elijohnsonn/Four-Topology-MOSbius/schematic review/Final Schematic Review (Shortened).pdf

# C1 Four Topology MOSbius

# Schematic Review Slides 07/03

LINK to Video (https://drive.google.com/file/d/1neRtkqYy5f7emF2jaVGr4DKSbaQKqrfV/view?usp=drive_link)

Discord name | Affiliation | Experience | Role
elij0100 | Columbia University | Undergraduate | Team Lead
boibun. | Columbia University | Undergraduate | Team Member
maxdrucker_83950 | Columbia University | Undergraduate | Team Member
Manwell | Columbia University | Undergraduate | Team Member

# Project Information

## Goal: To design and fabricate a chip containing several of the most common

amplifier topologies, all with accessible pins, so that a student can wire up, test,

## characterize, and compare each amplifier. Write a short lab manual to accompany

the chip (consider during design, but can follow design/layout submission).

## Students measure DC gain, GBW, slew rate, stability, PSRR, etc. for each amplifier, learning the trade-offs through hands-on experimentation

# System Overview

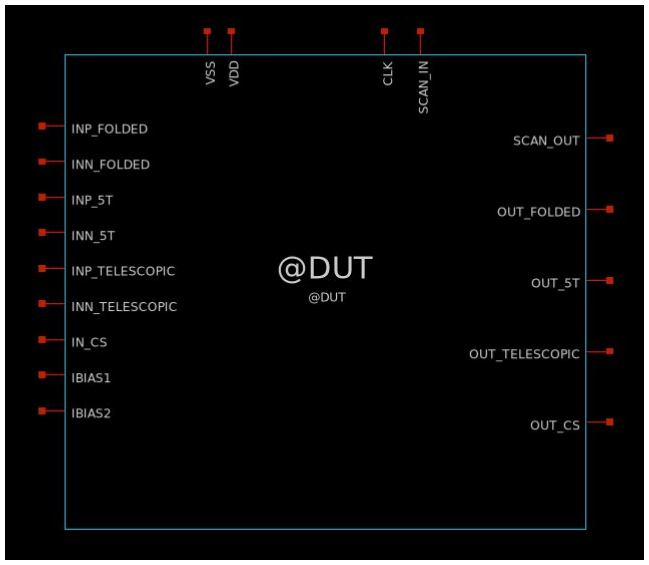
[picture p1: figure]

Total Pins: 17

Global Input (2): VDD, VSS

Digital Input (2): Scan In, Clock

Digital Output (1): Scan Out

Analog Input (8): IREF, IN(CS), INP/INN (5T), INP/INN (Telescopic), INP/INN (Folded)

Analog Output (4): OUT (CS), OUT (5T), OUT (Telescopic), OUT (Folded)

# System Block Diagram

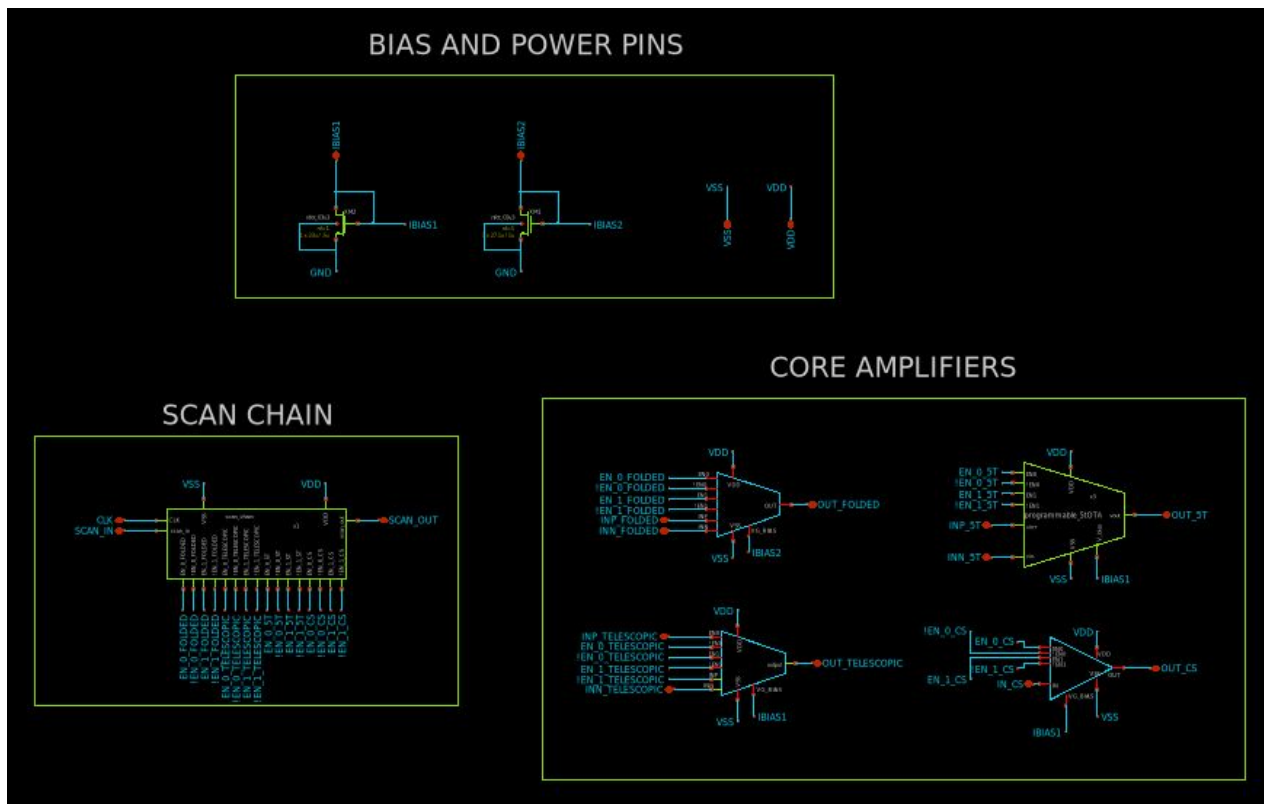
[picture p2: figure]

In practice, we will not have two separate bias currents. At the moment, there is some
mismatch between the initial current mirrors in the
amplifiers. This will be fixed so that we use only one externally generated bias current for the entire chip.

# System Testbench

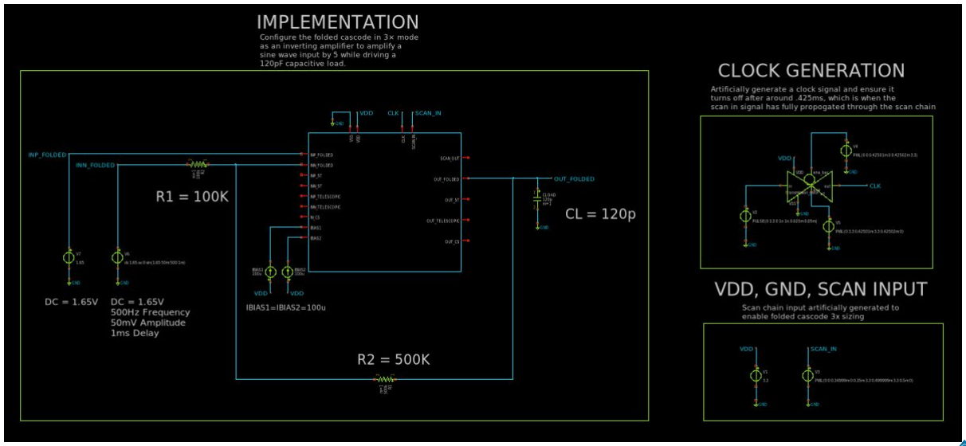
[picture p3: figure]

# System Simulation Results

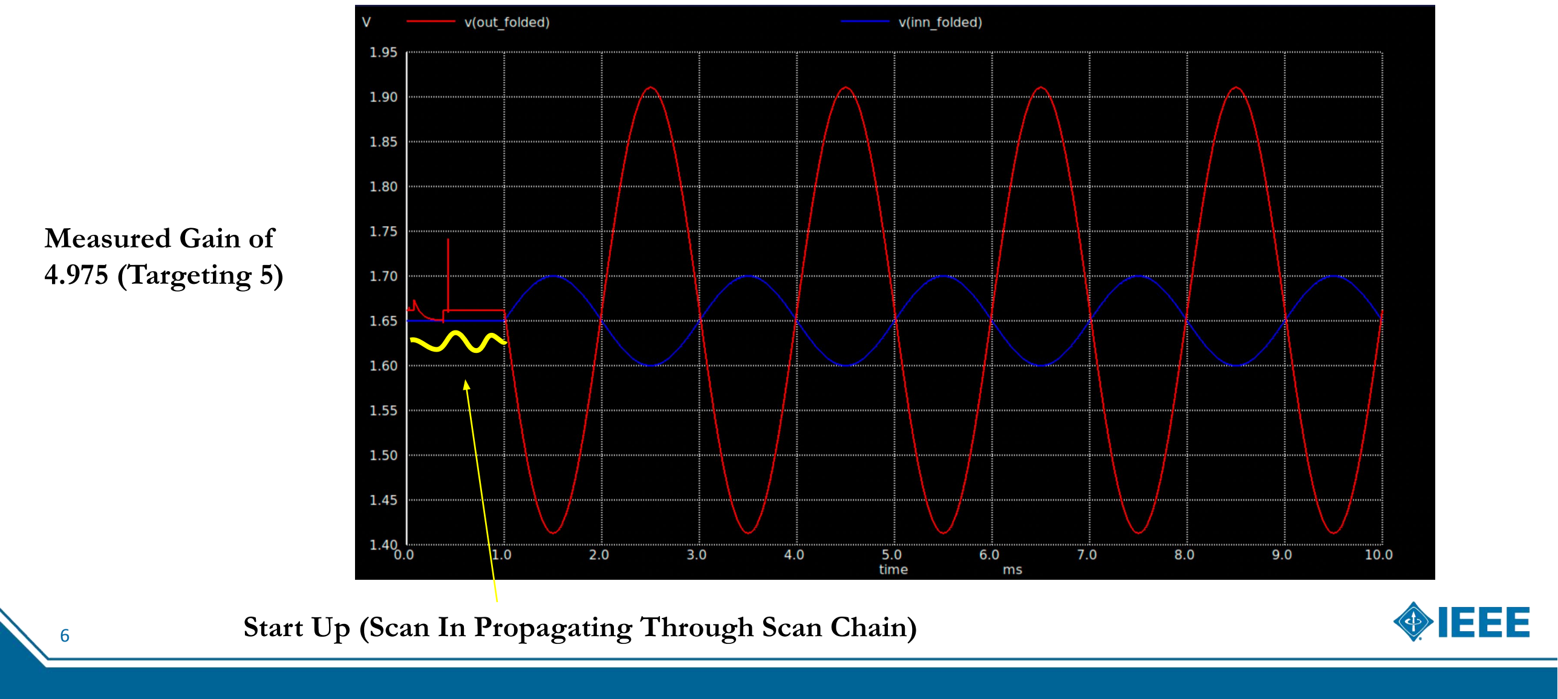
[picture p4: figure]
Measured Gain of 4.975 (Targeting 5)

Start Up (Scan In Propagating Through Scan Chain)

# Programmable Folded Cascode Schematic

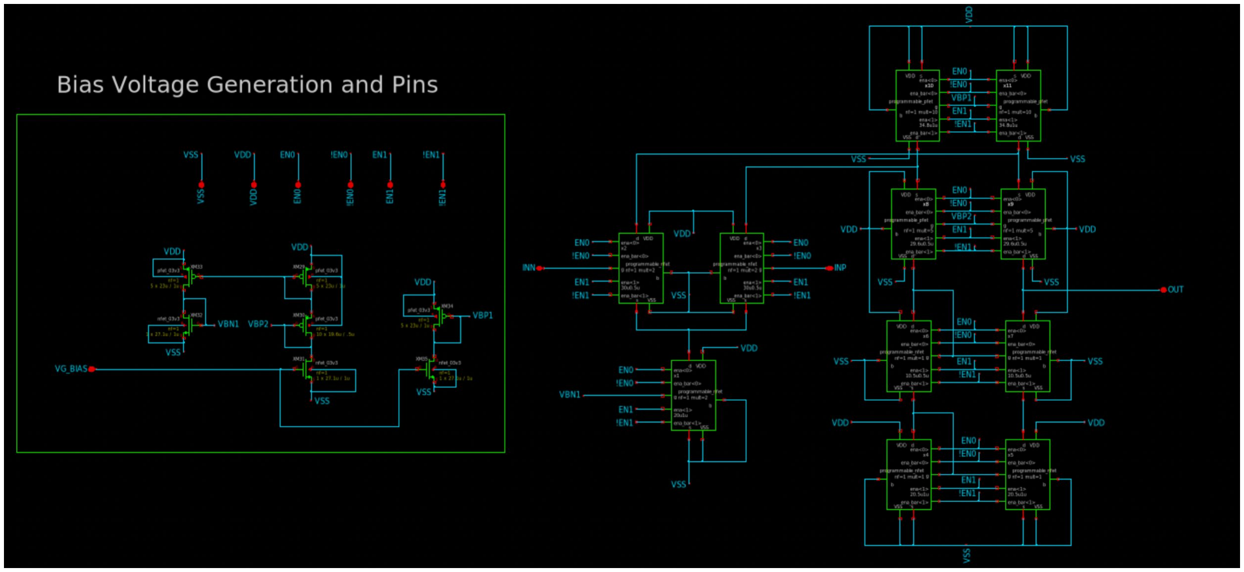
[picture p5: figure]

# Sizing and Device Information

Device | Role | W (µm) | L (µm) | ID (µA)
XM10/XM11 | NMOS input pair | 60 | 0.5 | 75
XM12 | NMOS tail | 40 | 1 | 150
XM2/XM5 | PMOS current sources | 174 | 1 | 150
XM3/XM4 | PMOS cascodes | 148 | 0.5 | 75
XM6/XM7 | NMOS cascodes | 10.5 | 0.5 | 75
XM8/XM9 | NMOS mirrors | 20.5 | 1 | 75
- VDD = 3.3 V
- IBIAS = 100 uA
- 3.3 V Devices
- Sizing for the
original amplifier
and base sizing for
programmable
amplifier is listed in
the table
- Total current
consumption is
approximately
300uA, giving
roughly 1mW at
3.3V

# AC Open-Loop

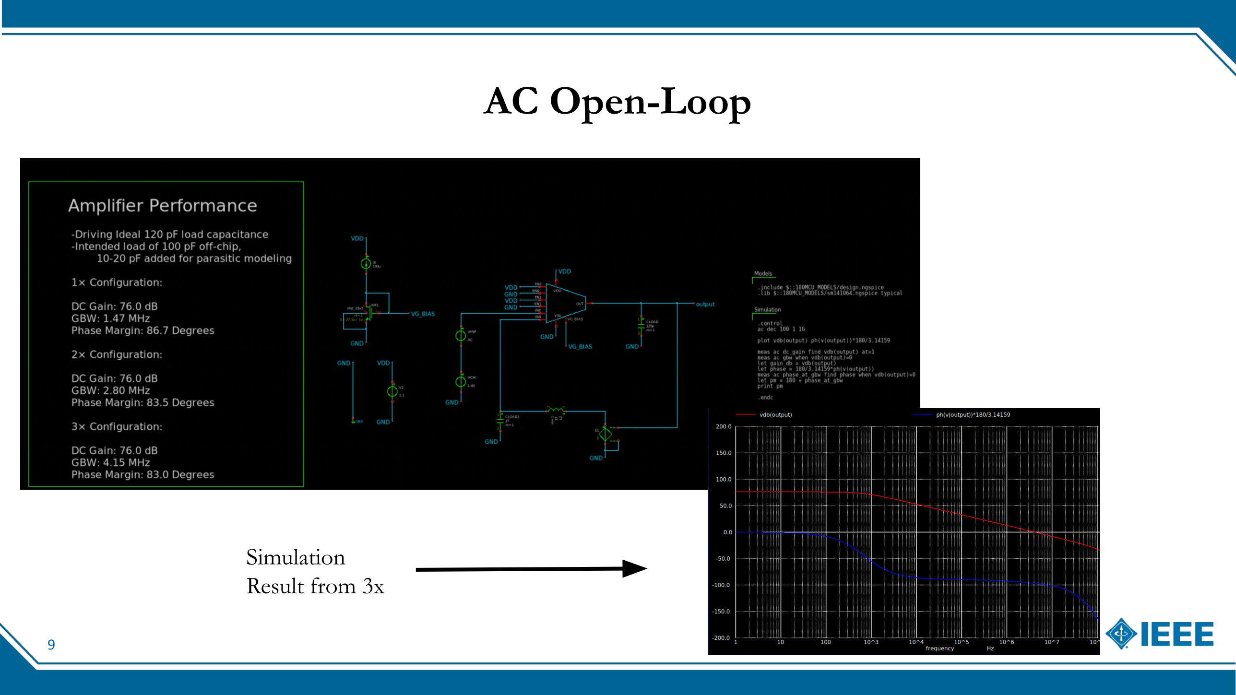
[picture p6: page 9]

Simulation
Result from 3x

# Programmable Telescopic Cascode

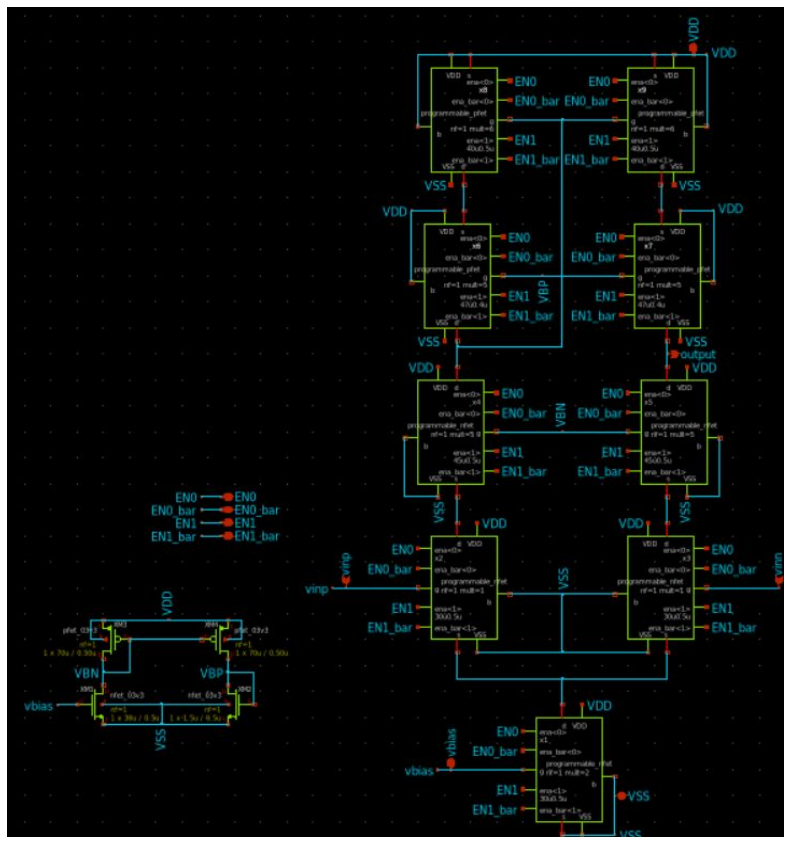
[picture p7: figure]

ID | Programmable | MOSFET | W (µm) (1x) | L (µm) (1x) | Multiplier

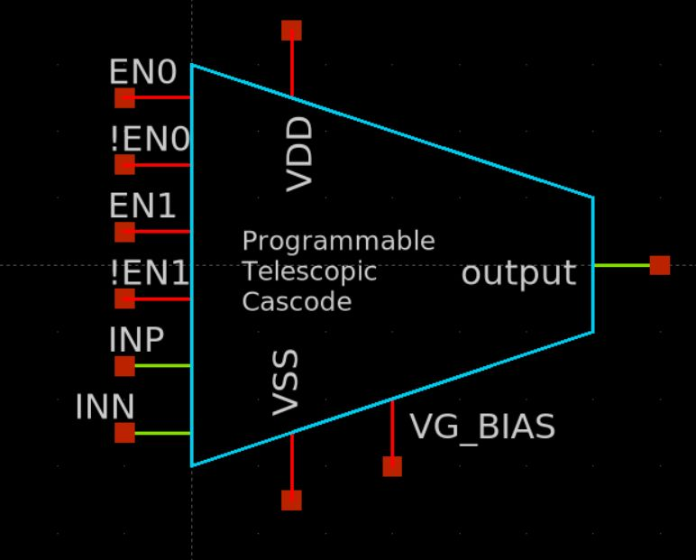
[picture p8: figure]

X1 | Programmable | 30 | .5 | 2
X2, X3 | Programmable | 30 | .5 | 1
X4, X5 | Programmable | 30 | .5 | 6
X6, X7 | Programmable | 47 | .4 | 5
X8, X9 | Programmable | 30 | .5 | 8
XM3, XM4 | PMOS | 70 | .5 | 1
XM2 | NMOS | 1.5 | .5 | 1
XM1 | NMOS | 30 | .5 | 1

Symbol View

# AC Open Loop

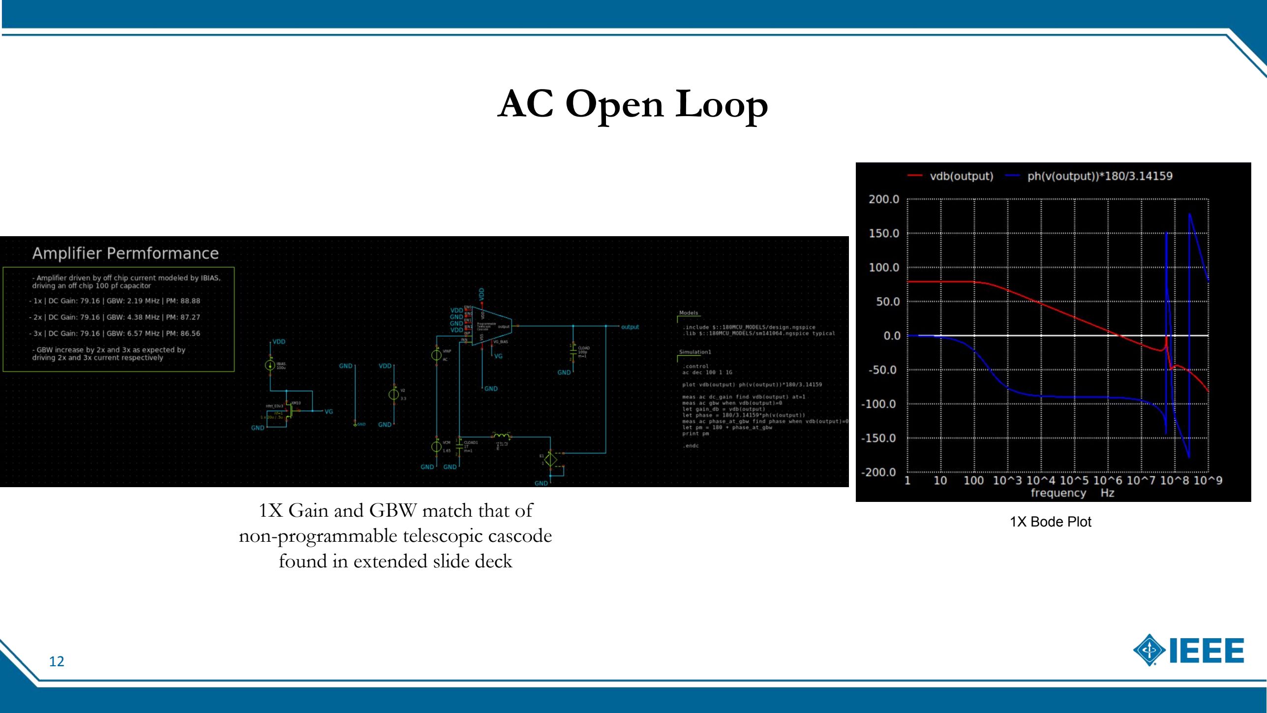
[picture p9: page 12]

1X Gain and GBW match that of non-programmable telescopic cascode found in extended slide deck

1X Bode Plot

# Scan Chain

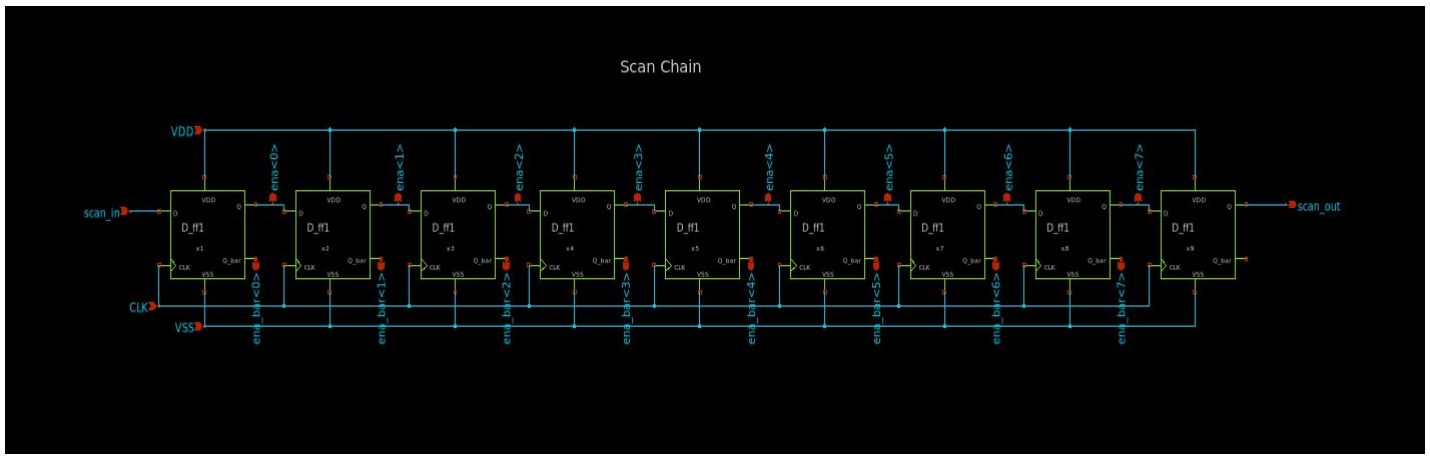
[picture p10: figure]

# Scan Chain Simulation

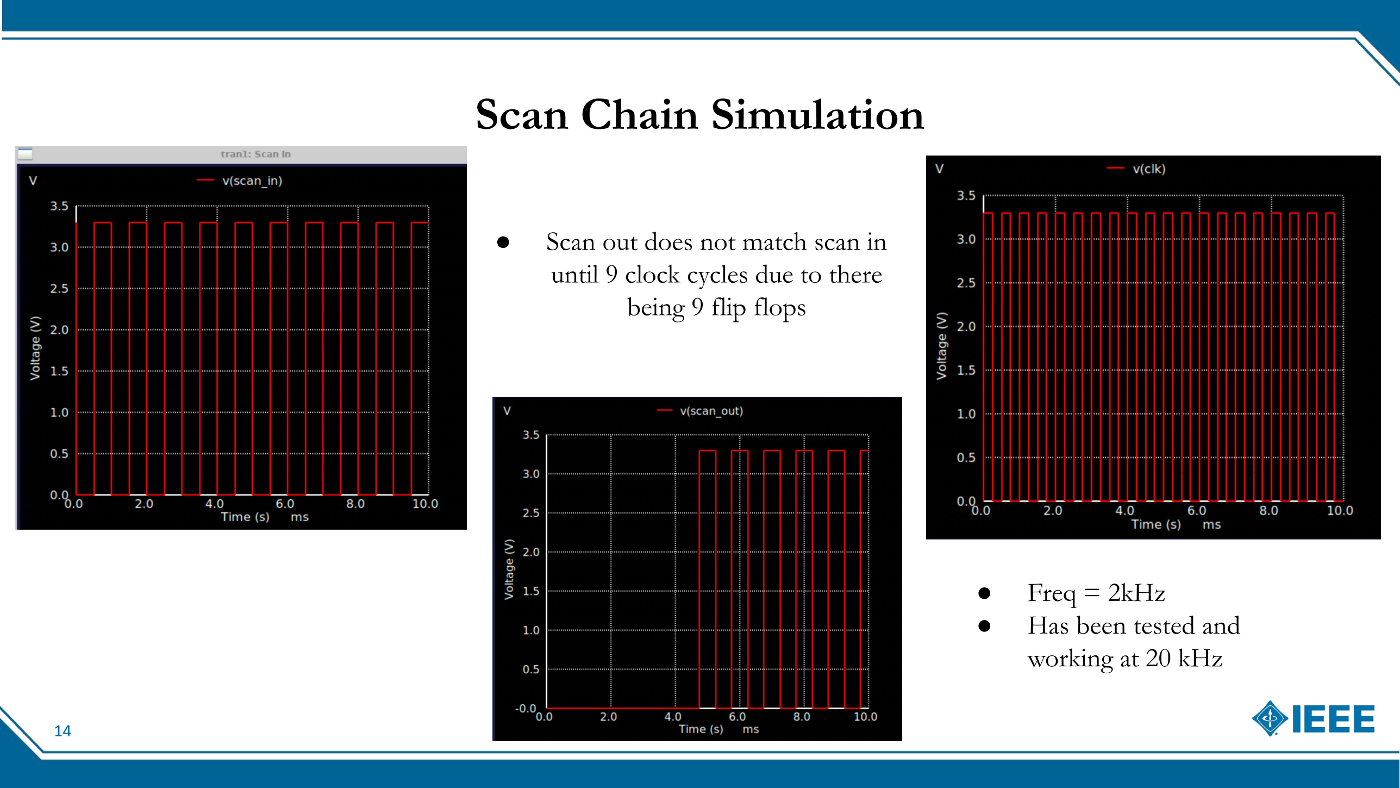
[picture p11: page 14]

- Freq = 2kHz
- Has been tested and
working at 20 kHz
- Scan out does not match scan in until 9 clock cycles due to there being 9 flip flops

# Programmable Transistors

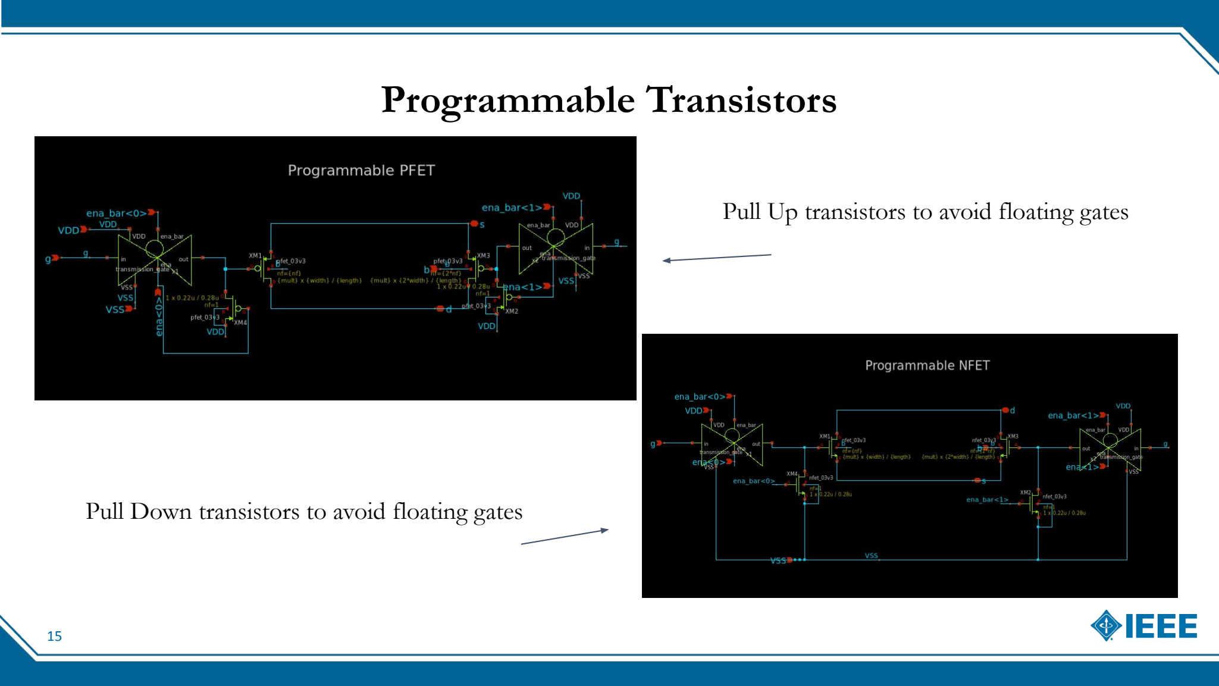
[picture p12: page 15]

Pull Down transistors to avoid floating gates

Pull Up transistors to avoid floating gates

# Programmable 5-Transistor OTA

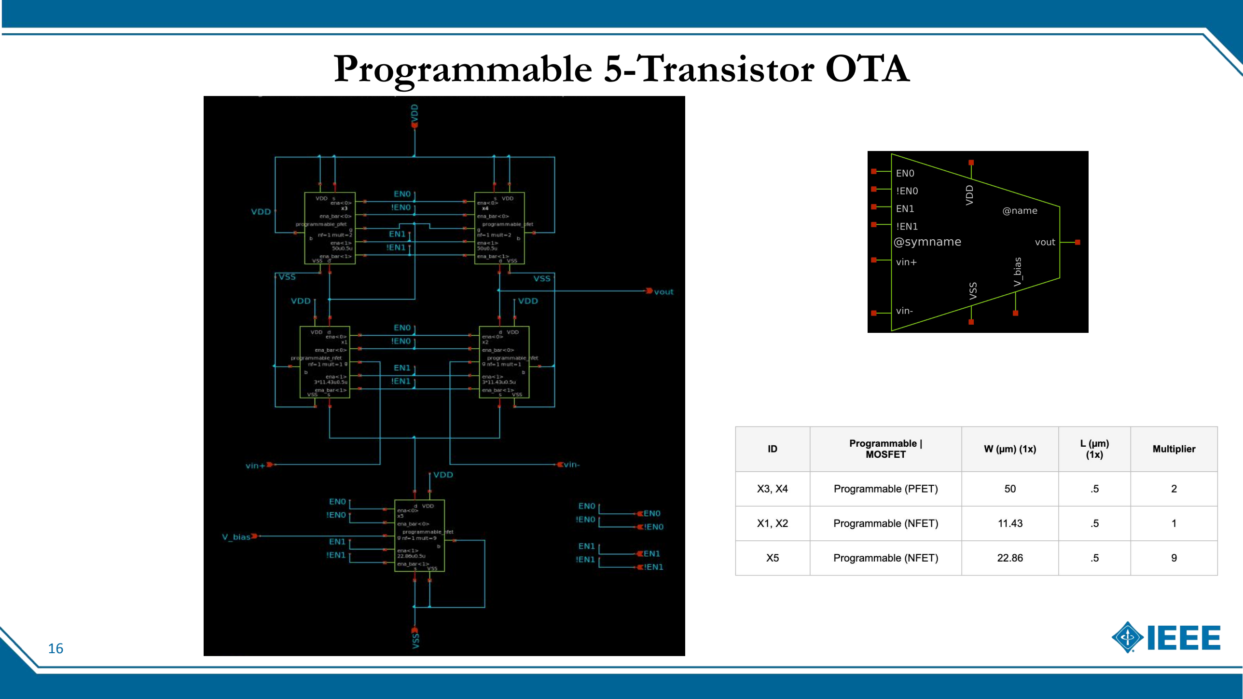
[picture p13: page 16]

# Programmable 5-Transistor OTA - DC Unity

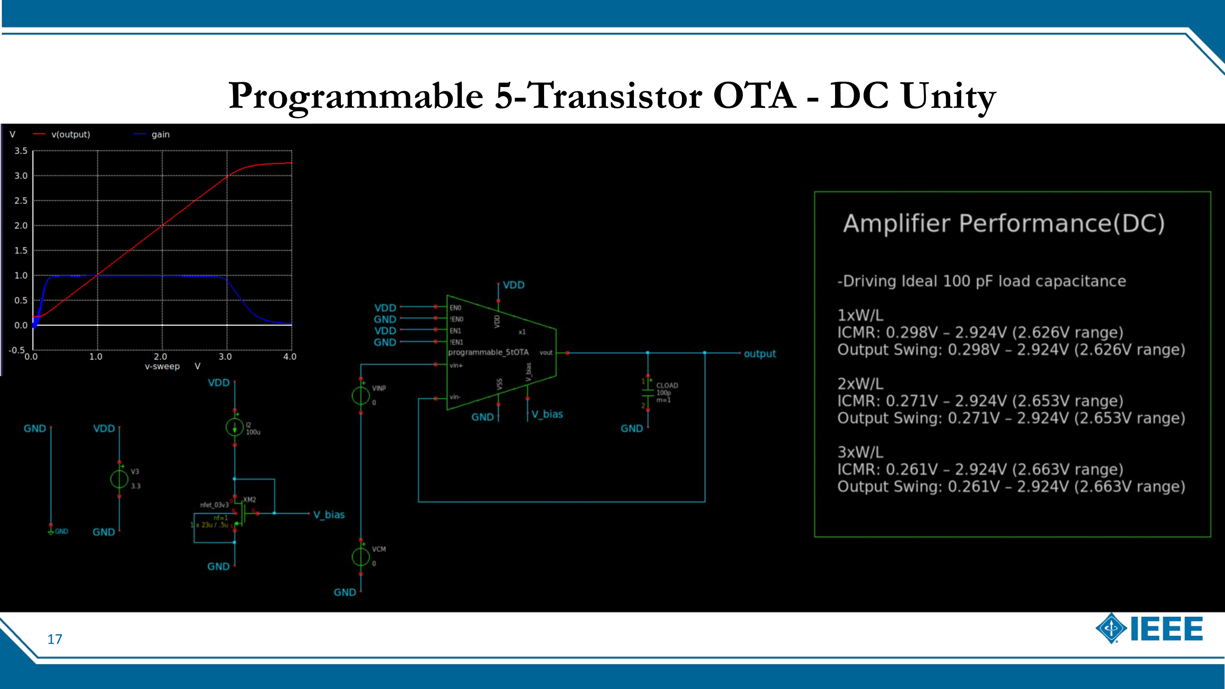
[picture p14: page 17]

# Programmable 5-Transistor OTA - Slew Rate

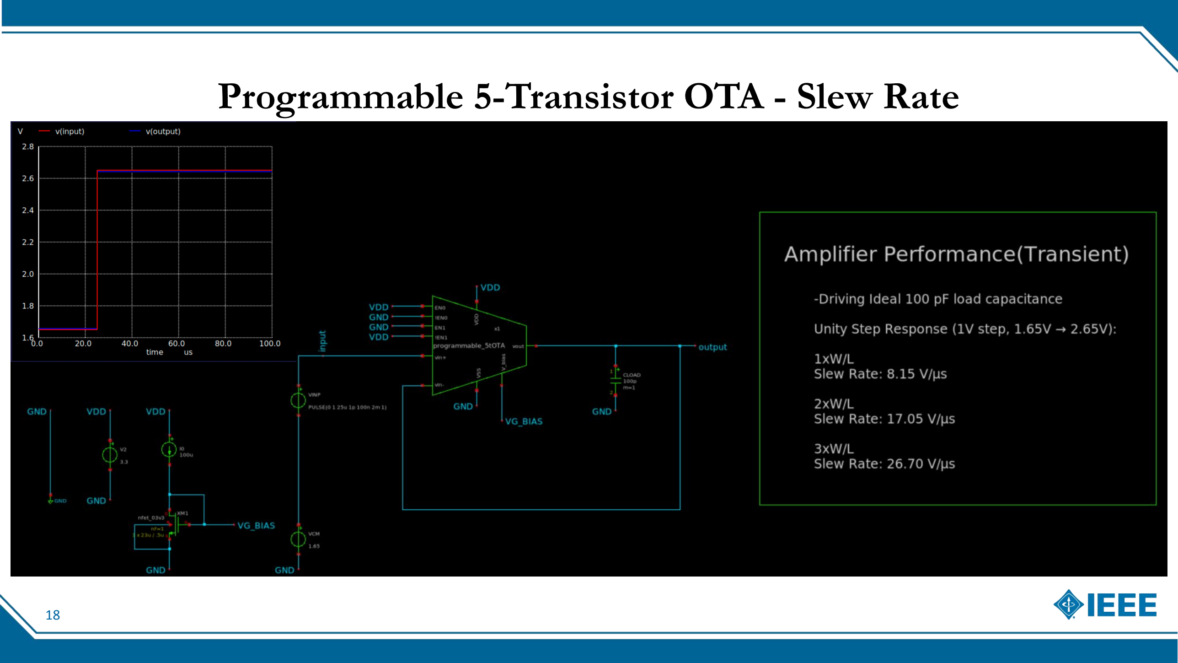
[picture p15: page 18]

# Programmable 5-Transistor OTA AC

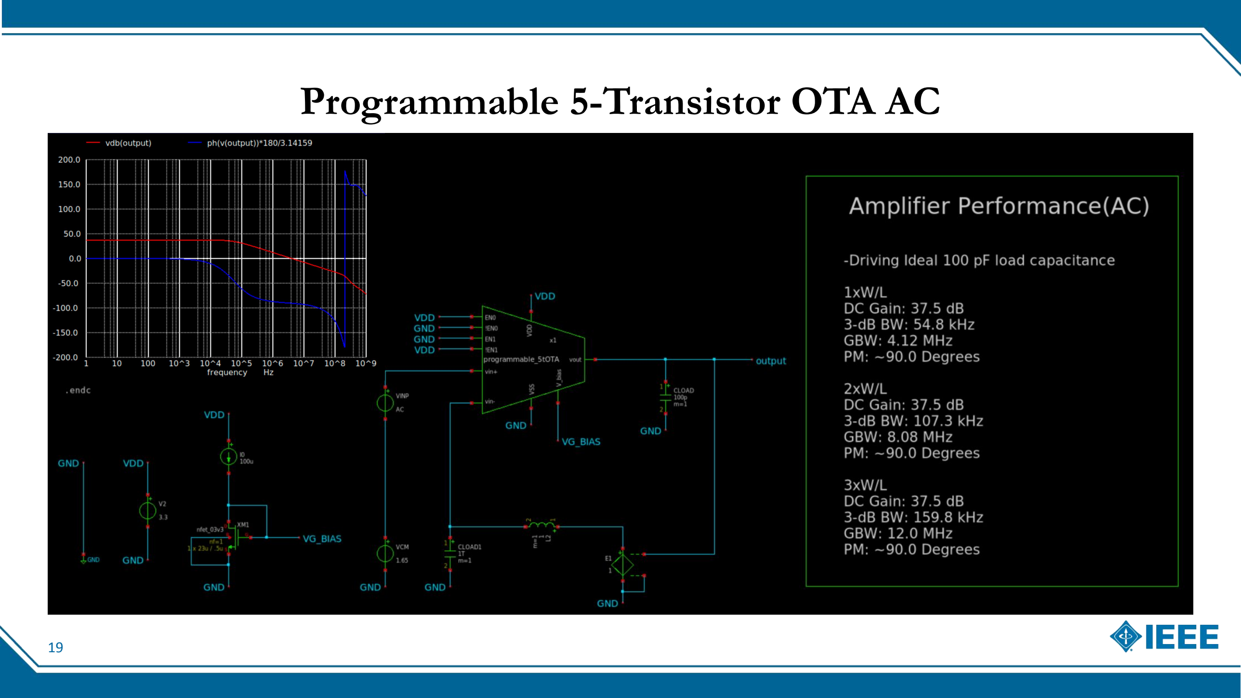
[picture p16: page 19]

# Next Steps

- Continue to Test System-Level Configurations and Specifications
- Experiment and Document Two-Stage Configurations, Compensation
- More Characterization Simulations (Noise and PSRR)
- Begin Layout

# Thank You!

# Any feedback is greatly appreciated. Please view our full slide deck linked on our repository and issue for more

simulations and calculations.
