elijohnsonn/Four-Topology-MOSbius/brief pex/Brief PEX Results.pdf

# C1 Four Topology MOSbius

## Brief PEX Results and Introduction

Discord name | Affiliation | Experience | Role
elij0100 | Columbia University | Undergraduate | Team Lead
boibun. | Columbia University | Undergraduate | Team Member
maxdrucker_83950 | Columbia University | Undergraduate | Team Member
Manwell | Columbia University | Undergraduate | Team Member

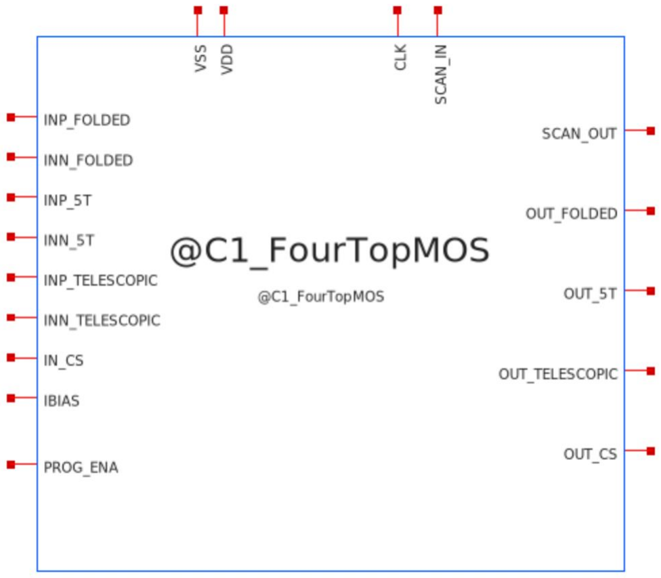
[picture p36: figure]
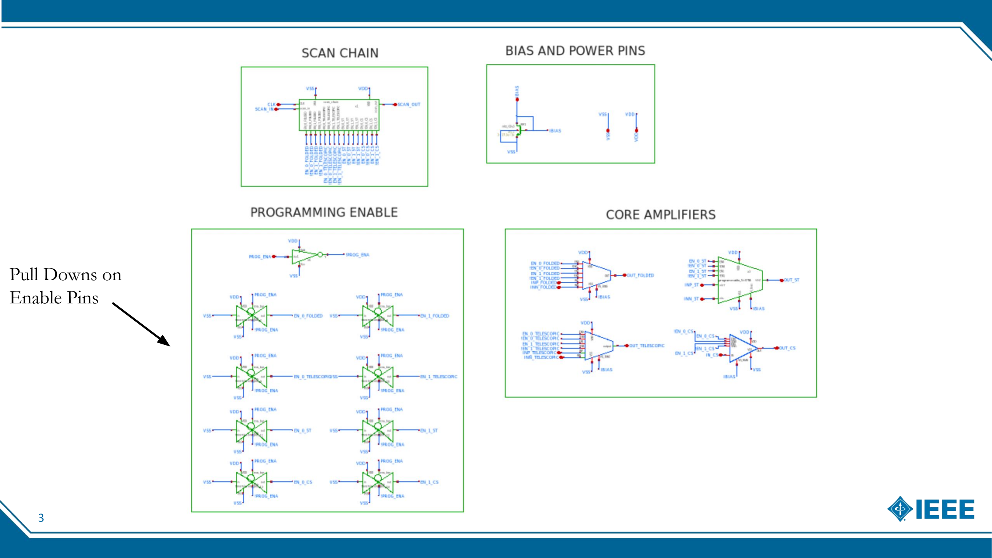
[picture p37: page 3]

Pull Downs on
Enable Pins

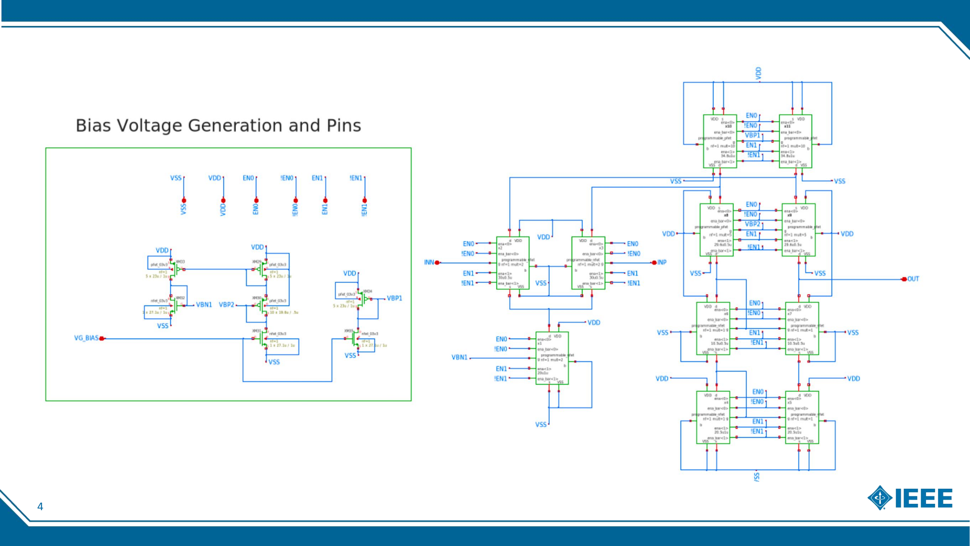
[picture p38: page 4]

# Folded Cascode Sizing

Device | Role | W (µm) | L (µm) | ID (µA)
XM10/XM11 | NMOS input pair | 60 | 0.5 | 75
XM12 | NMOS tail | 40 | 1 | 150
XM2/XM5 | PMOS current sources | 174 | 1 | 150
XM3/XM4 | PMOS cascodes | 148 | 0.5 | 75
XM6/XM7 | NMOS cascodes | 10.5 | 0.5 | 75
XM8/XM9 | NMOS mirrors | 20.5 | 1 | 75

(Default sizing shown,

## for 2x, 3x, and 4x sizing, the width and bias current would scale respectively for all amplifiers)

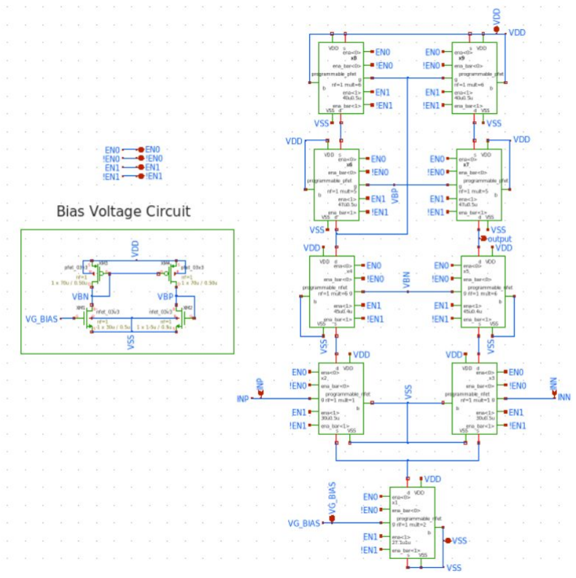
[picture p39: figure]

Device | Role | W (µm) | L (µm) | ID (µA)
XM1 | NMOS Tail | 60 | 0.5 | 200
XM2/XM3 | Input Pair | 30 | 0.5 | 100
XM4/XM5 | NMOS Cascode | 180 | 0.5 | 100
XM6/XM7 | PMOS Cascodes | 235 | 0.4 | 100
XM8/XM9 | PMOS Current Sources | 240 | 0.5 | 100

# Telescopic Cascode Sizing

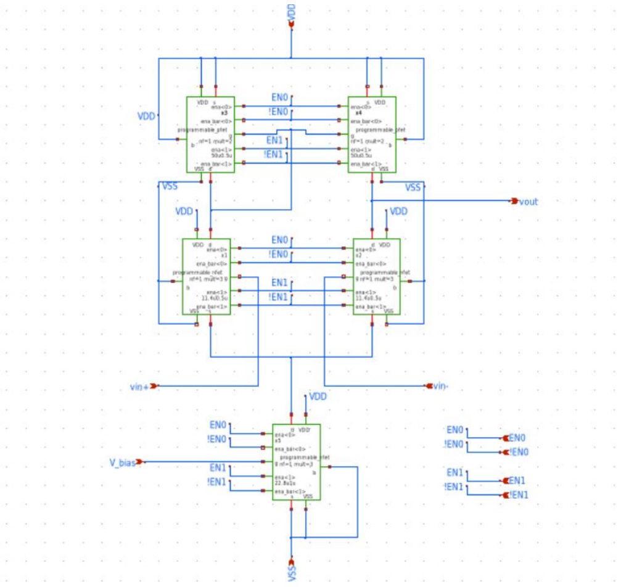
[picture p40: figure]

# 5-Transistor Sizing

Device | Role | W (µm) | L (µm) | ID (µA)
XM1/XM2 | Input Pair | 34.2 | 0.5 | 150
XM3/XM4 | PMOS Active Load | 100 | 0.5 | 150
XM5 | NMOS Tail | 68.4 | 0.5 | 300

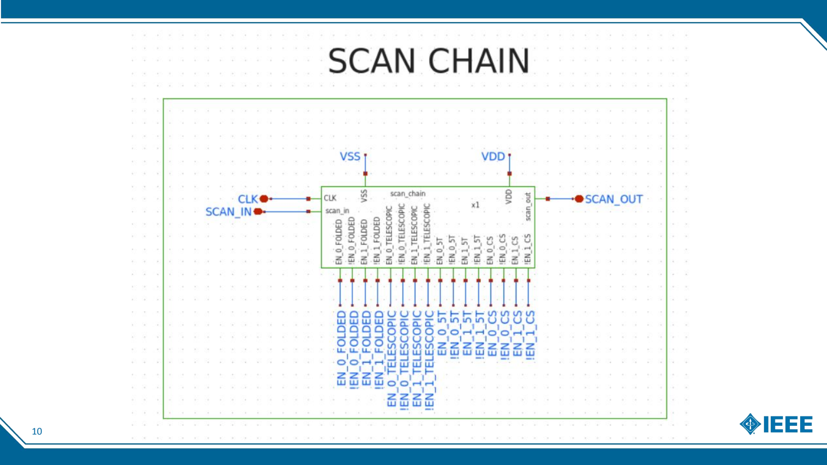
[picture p41: page 10]

Programmable PFET | Programmable NFET

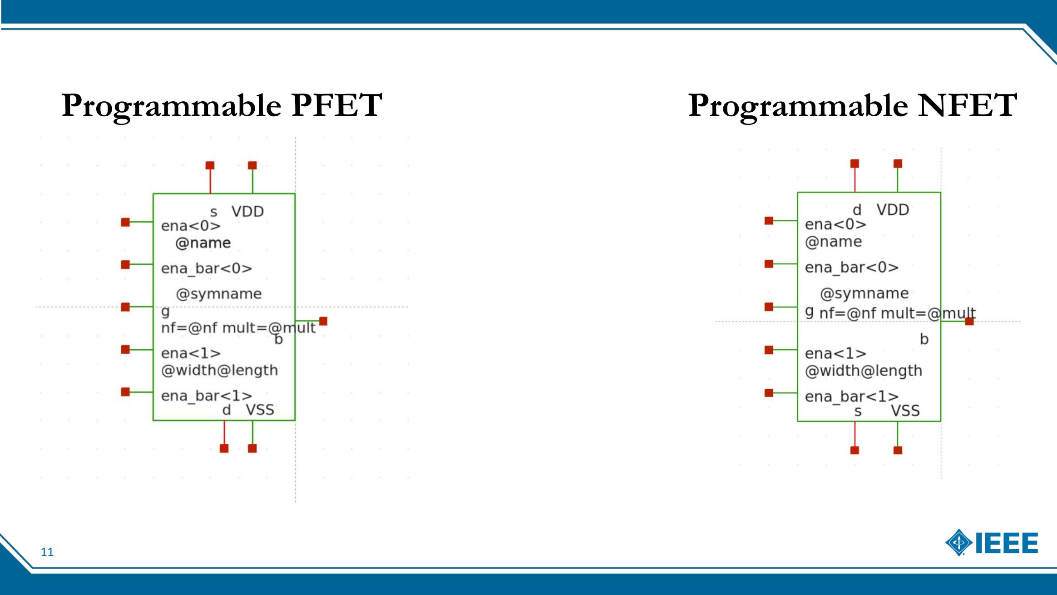
[picture p42: page 11]

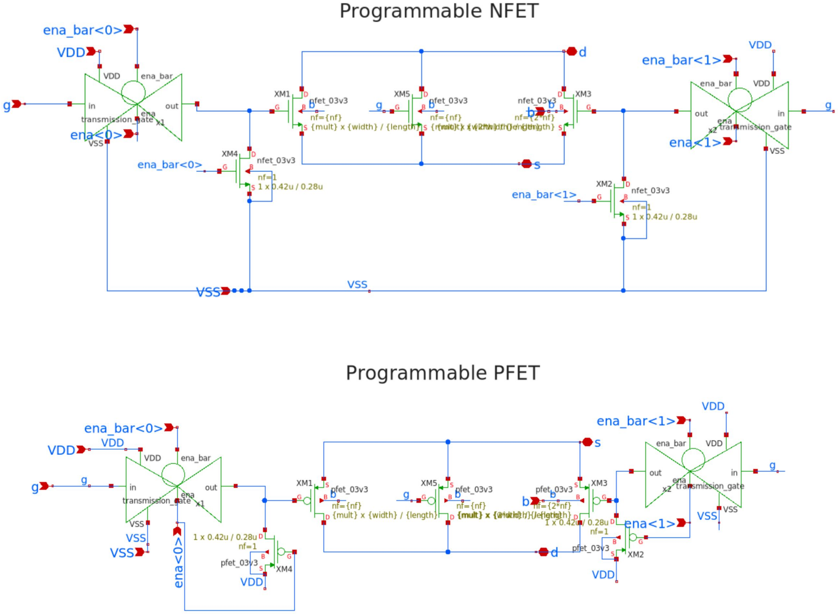
[picture p43: figure]
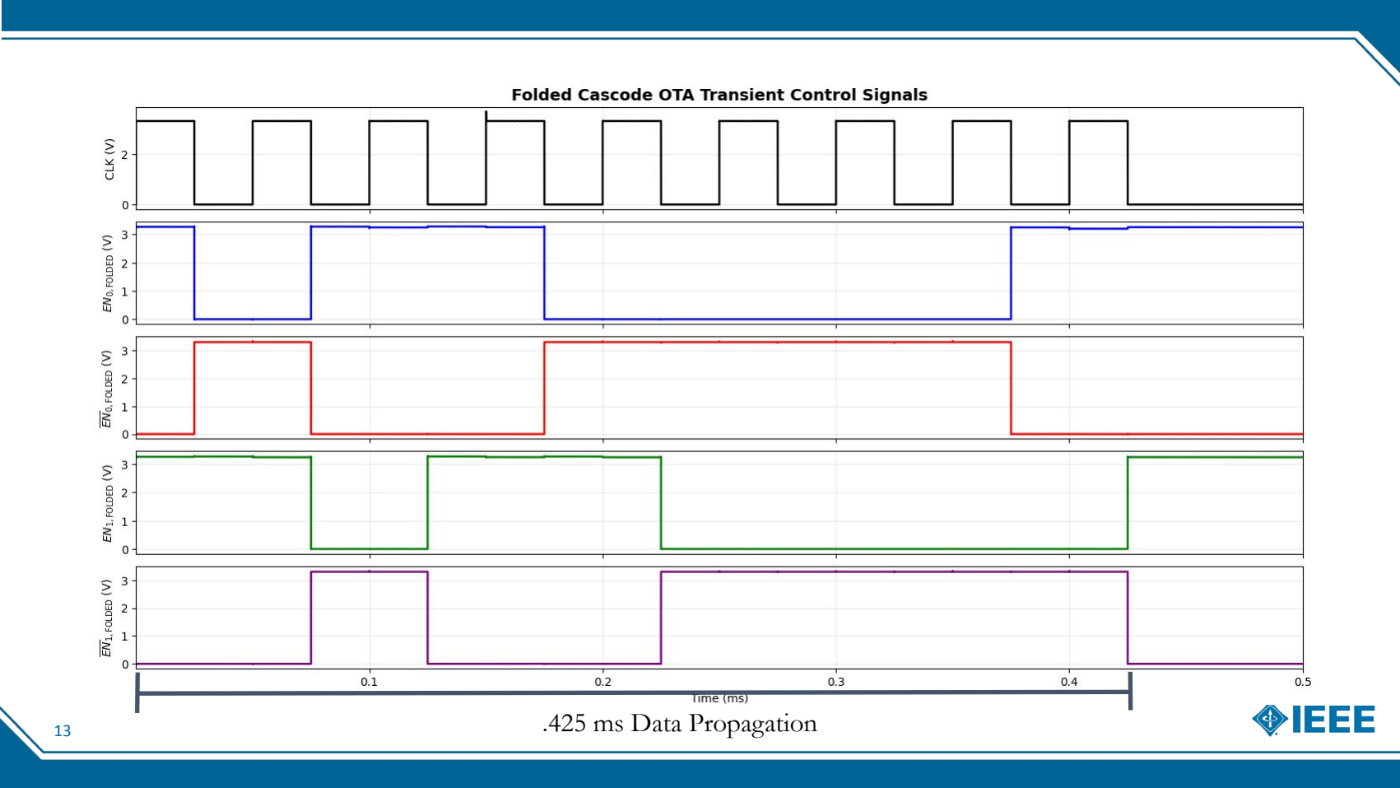
[picture p44: page 13]

13 | .425 ms Data Propagation

# Start-Up CleaningCircuitry (SIMULATION ONLY)

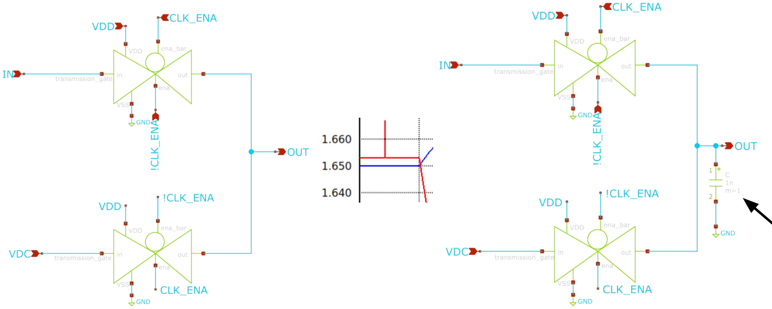
[picture p45: figure]

Start-up transients are present at the output when enable signals propagate through the scan chain. To mitigate this, a switch ties the output to VCM while the enable signal propagates. Once the enable logic stabilizes, the switch restores the actual output to the output pin

1nF cap to create a
more overdamped
response, only use at
lower frequencies

The following configuration uses the Four-Topology MOSbius set up as an inverting amplifier. The gain of 5 is established using external feedback resistors, 500kΩ and 100kΩ. A switch is included to tie the outputs to VCM during start-up, preventing instability or undefined states as the circuit powers on. There is no additional capacitance present in this implementation of the switch. This setup also uses a PEX (parasitic-extracted) netlist.

# Example Testbench

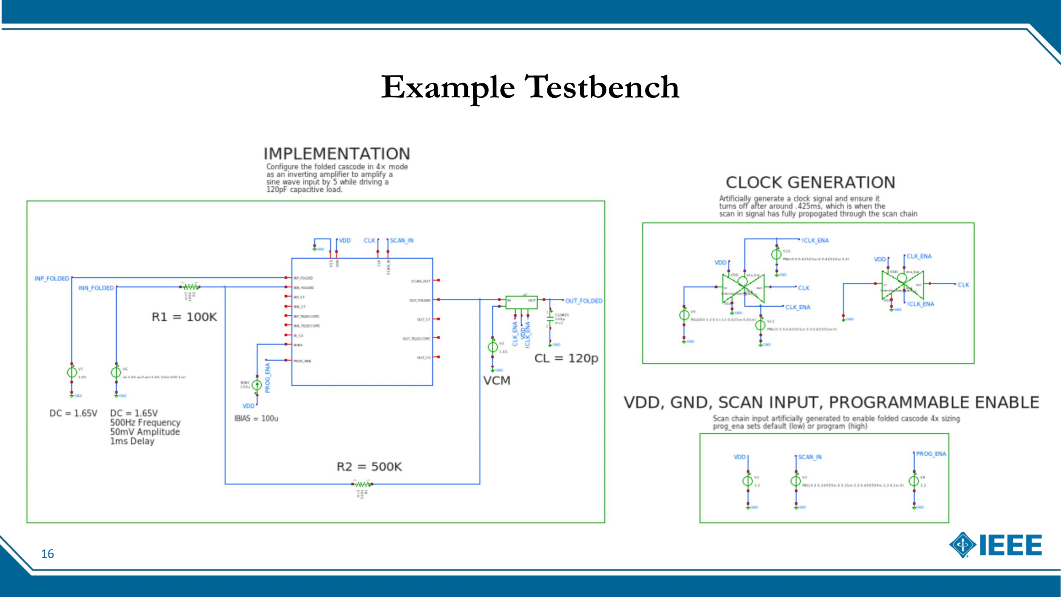
[picture p46: page 16]
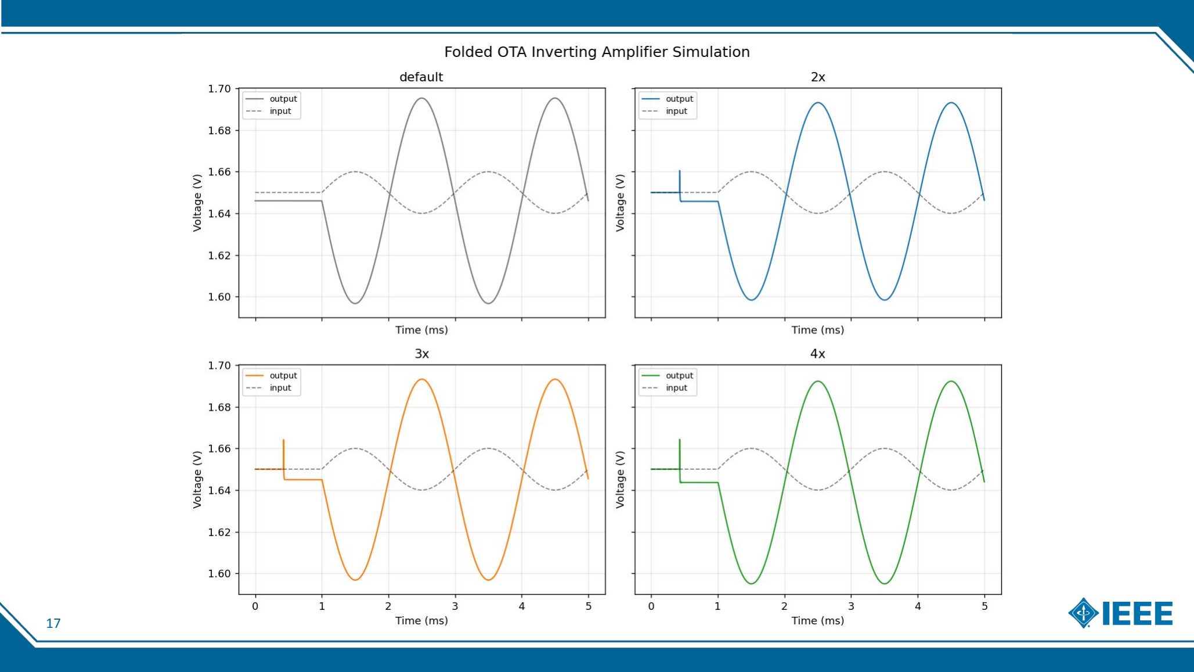
[picture p47: page 17]
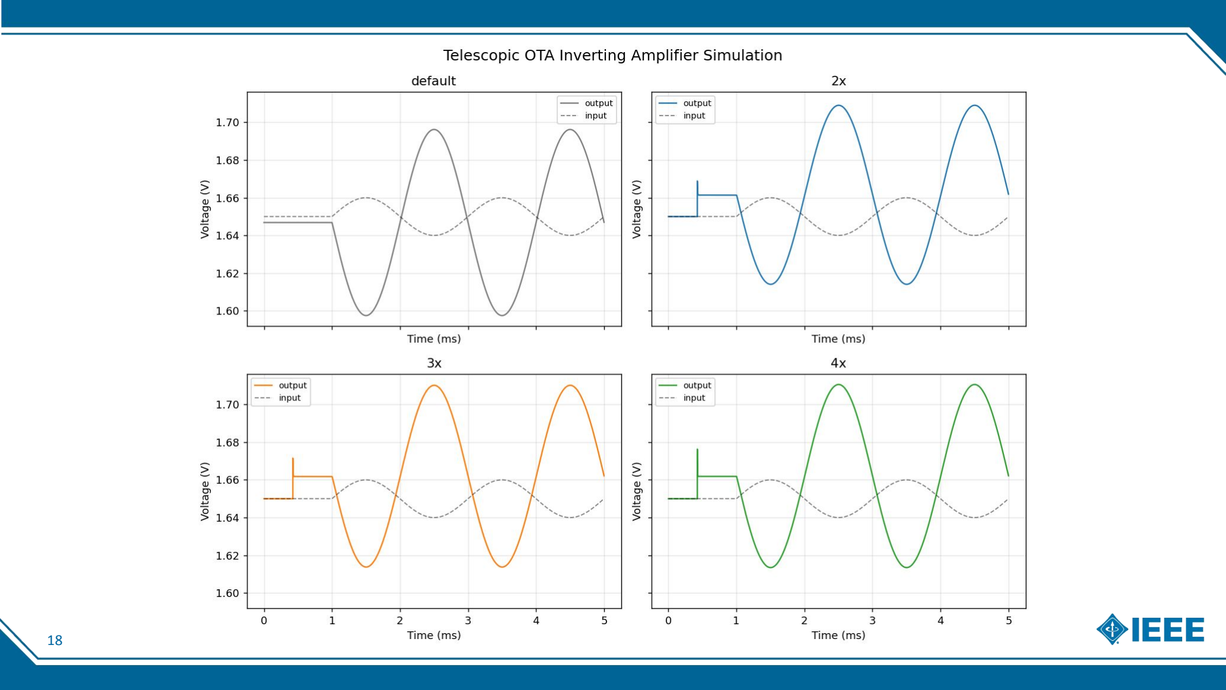
[picture p48: page 18]
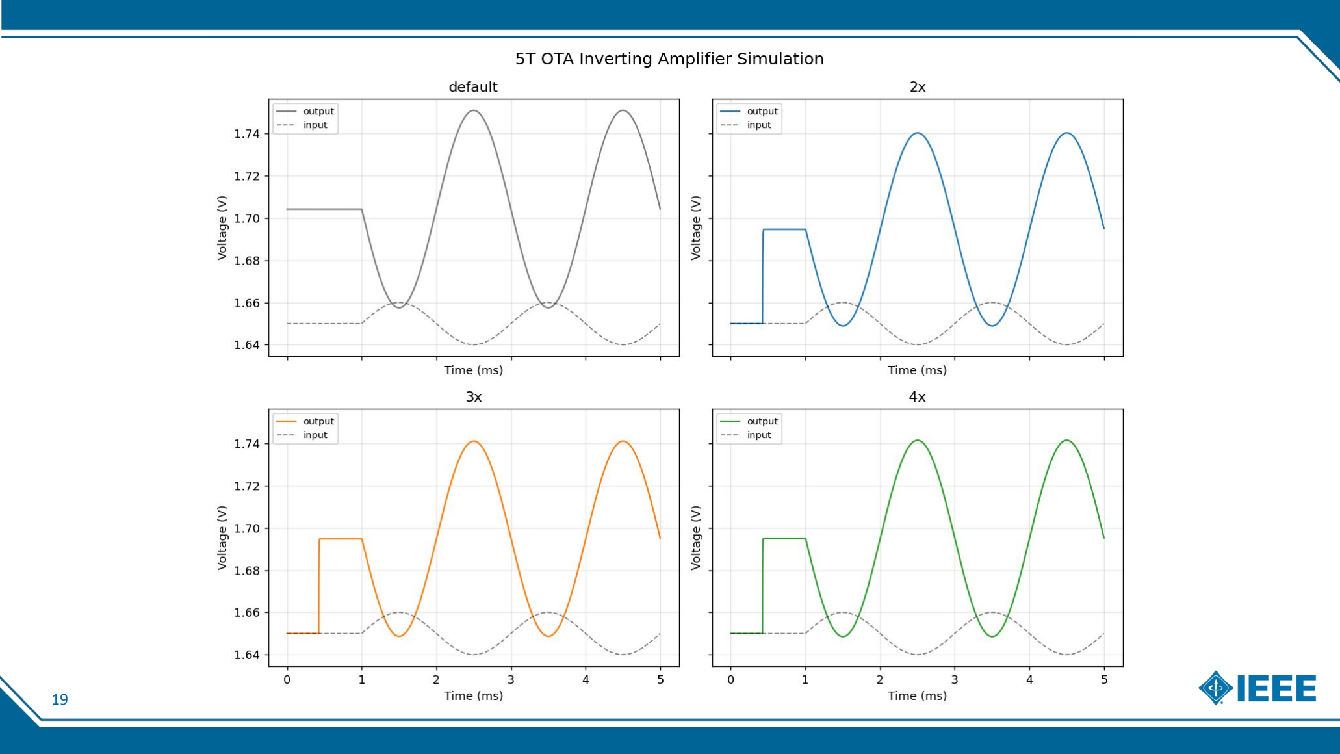
[picture p49: page 19]
