elijohnsonn/Four-Topology-MOSbius/top level/Top_Level_Verification.pdf

# C1 Four Topology MOSbius

Four Topology MOSbius

Discord name | Affiliation | Experience | Role
elij0100 | Columbia University | Undergraduate | Team Lead
boibun. | Columbia University | Undergraduate | Team Member
maxdrucker_83950 | Columbia University | Undergraduate | Team Member
Manwell | Columbia University | Undergraduate | Team Member


Pull Downs on
Enable Pins


## Folded Cascode Sizing

Device | Role | W (µm) | L (µm) | ID (µA)
XM10/XM11 | NMOS input pair | 60 | 0.5 | 75
XM12 | NMOS tail | 40 | 1 | 150
XM2/XM5 | PMOS current sources | 174 | 1 | 150
XM3/XM4 | PMOS cascodes | 148 | 0.5 | 75
XM6/XM7 | NMOS cascodes | 10.5 | 0.5 | 75
XM8/XM9 | NMOS mirrors | 20.5 | 1 | 75
- (Default sizing shown,
for 2x, 3x, and 4x
sizing, the width and
bias current would
scale respectively for all amplifiers)


Device | Role | W (µm) | L (µm) | ID (µA)
XM1 | NMOS Tail | 60 | 0.5 | 200
XM2/XM3 | Input Pair | 30 | 0.5 | 100
XM4/XM5 | NMOS Cascode | 180 | 0.5 | 100
XM6/XM7 | PMOS Sascodes | 235 | 0.4 | 100
XM8/XM9 | PMOS Current Sources | 240 | 0.5 | 100

## Telescopic Cascode Sizing


## 5-Transistor Sizing

Device | Role | W (µm) | L (µm) | ID (µA)
XM1/XM2 | Input Pair | 34.2 | 0.5 | 150
XM3/XM4 | PMOS Active Load | 100 | 0.5 | 150
XM5 | NMOS Tail | 68.4 | 0.5 | 300

## Common-Source Amplifier

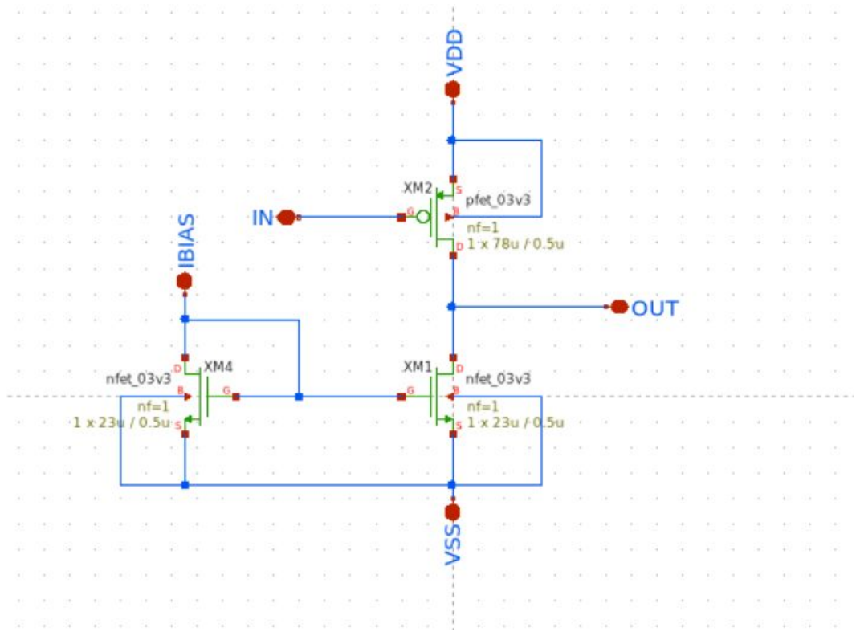
[picture p50: figure]
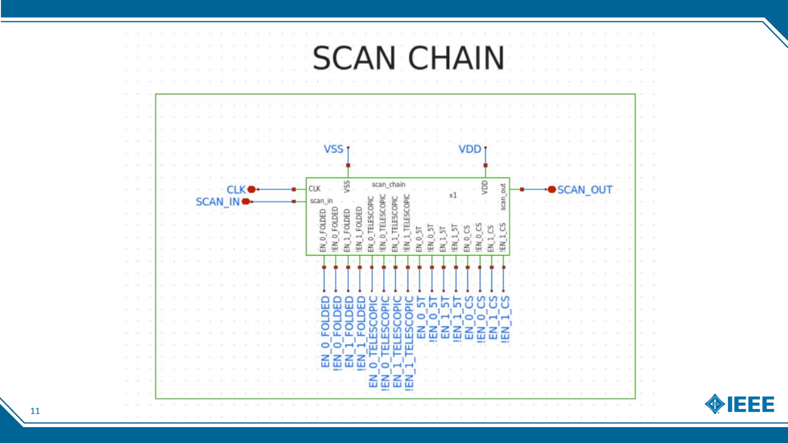
[picture p51: page 11]

Clock and Scan-In Signal are to be generated by a Raspberry Pi running micropython (can also be replaced by any other microcontroller). Data for any possible configuration can be propagated in .425 ms, and verified via the Scan-Out Pin. In the next slide, the D Flip-Flop outputs of EN0 and EN1 (and compliments) are displayed, propagated in .425 ms. At .425 ms the clock turns off, and with the enable bits set in place until the user chooses to reconfigure the Four Topology MOSbius.

*During this data propagation, in transient simulations, you will notice voltage spikes do to digital switching, which disappear after the clock is turned off.


13 | .425 ms Data Propagation


Programmable PFET | Programmable NFET

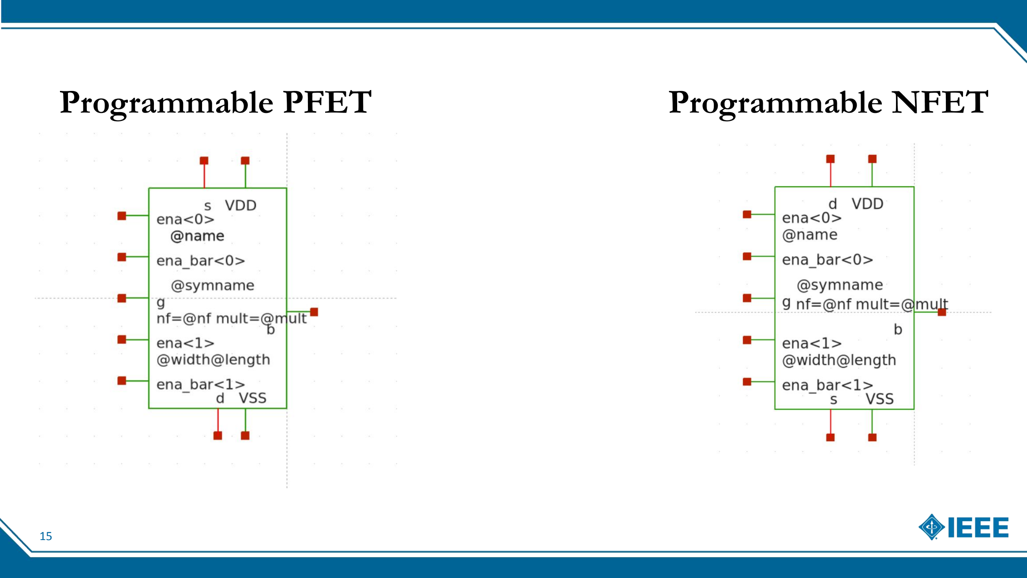
[picture p52: page 15]

## AC Simulations

The following AC Sims were extracted by hard coding the Programming Transistors (Setting the Enable Pins high or low without the need of the Scan Chain). AC sims were unable to be done directly via the Top-Level as SPICE was unable to find an operation point due to the presence of the digital platform. Instead, GBW was extracted via the GBW product. There is an error margin as result were limited by 1uS resolution simulations. These results can be found in the last slide.

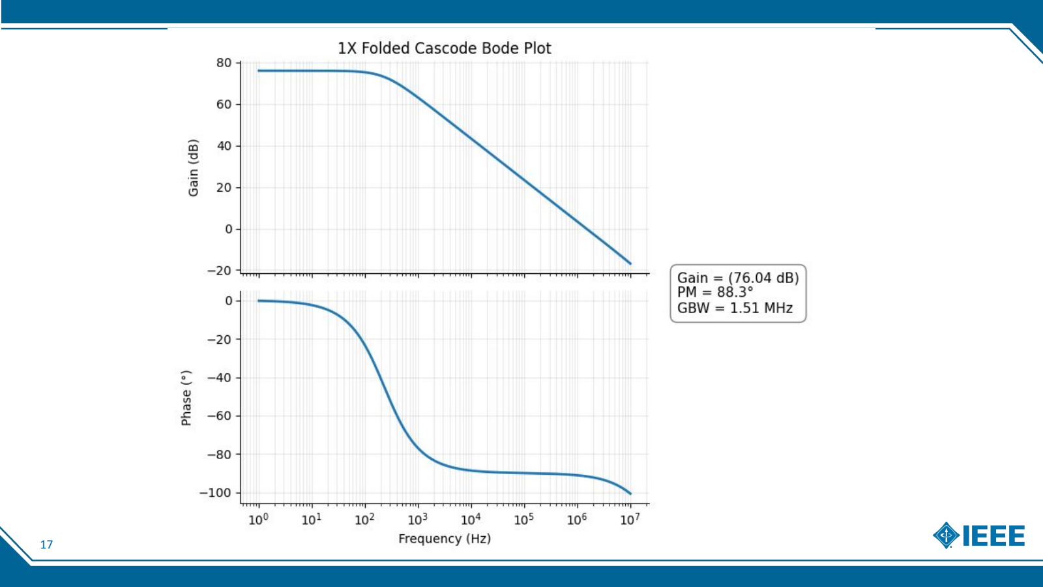
[picture p53: page 17]

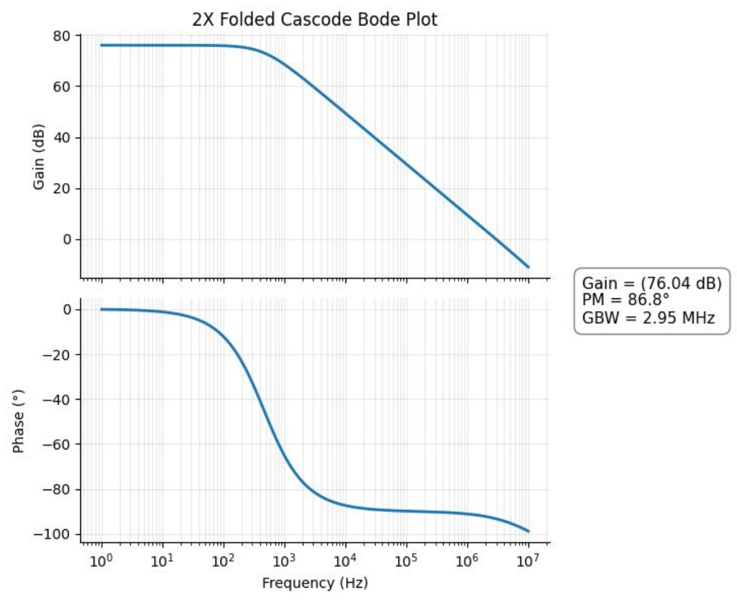
[picture p54: figure]

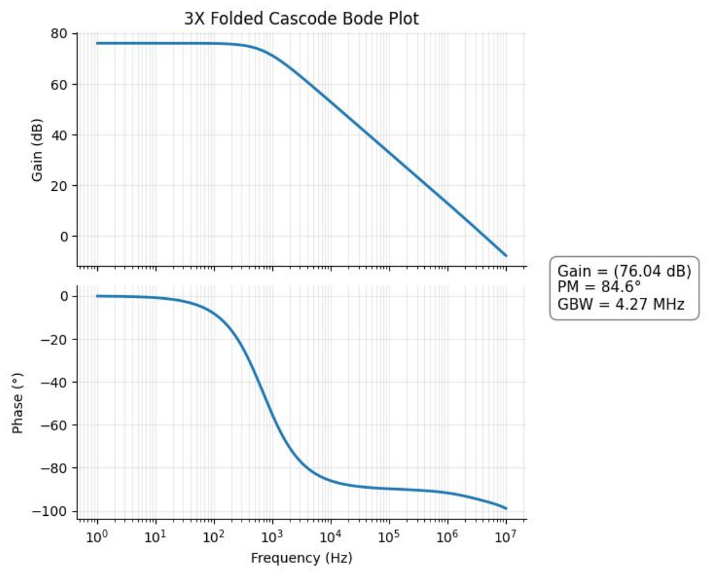
[picture p55: figure]
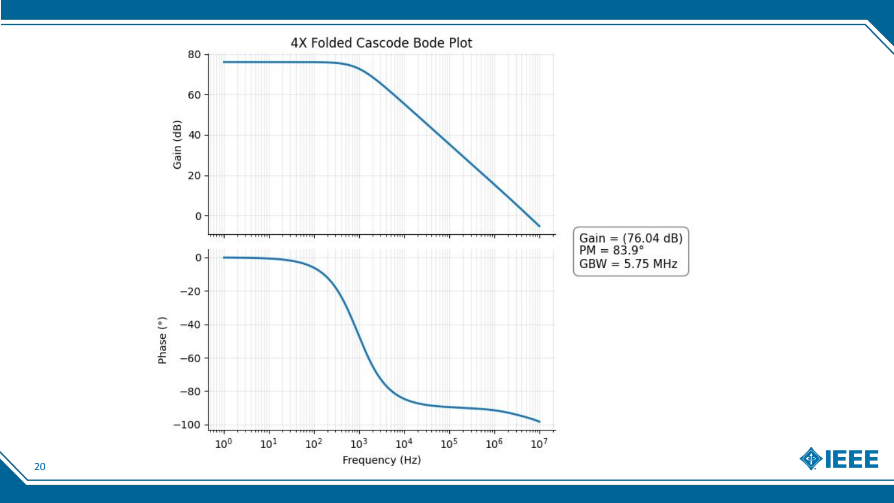
[picture p56: page 20]

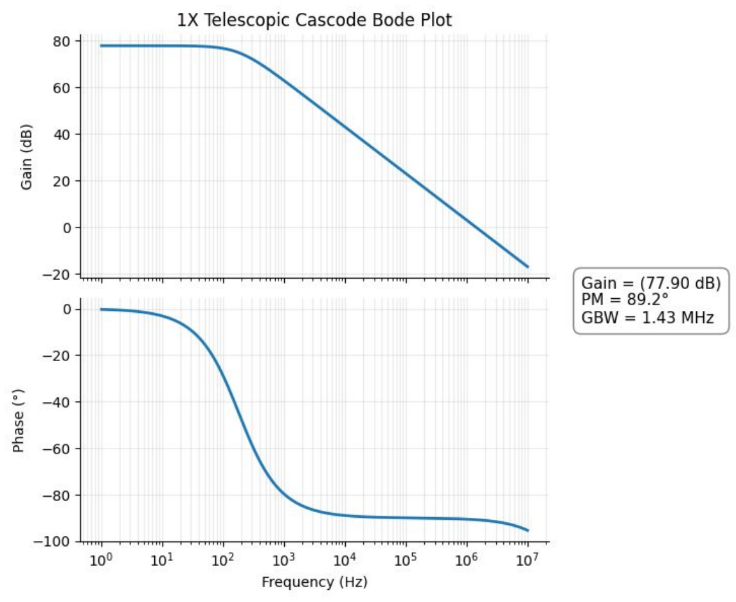
[picture p57: figure]

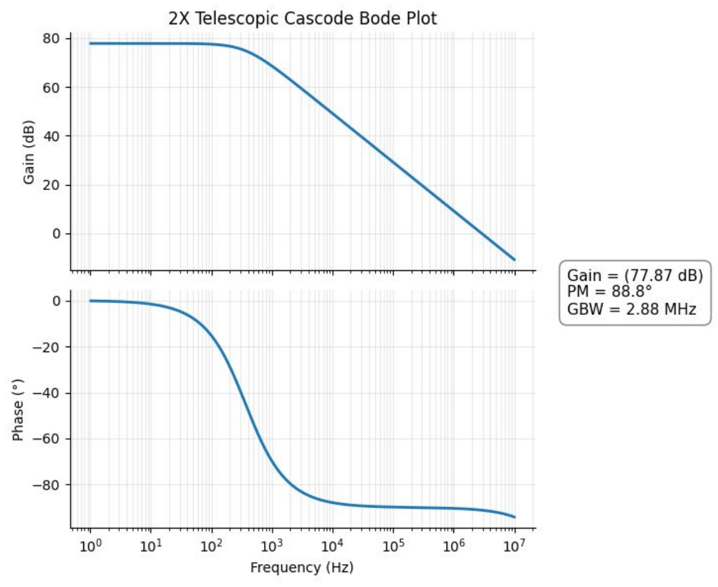
[picture p58: figure]

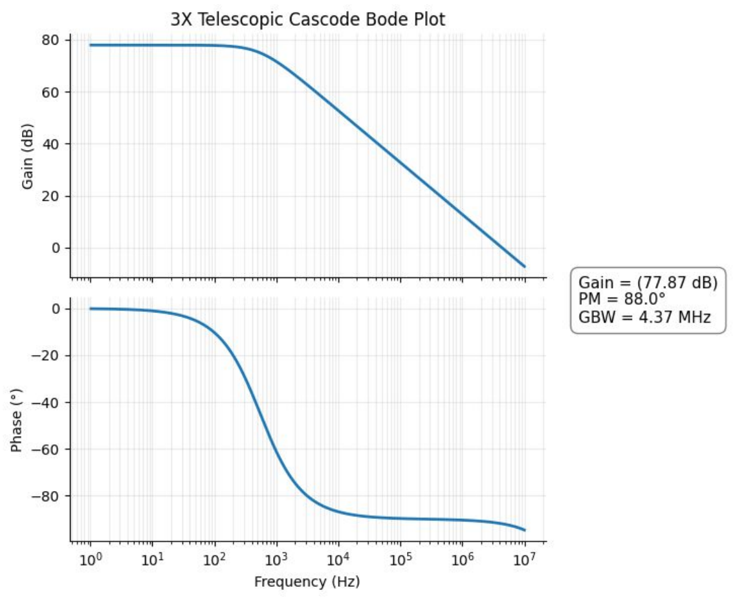
[picture p59: figure]

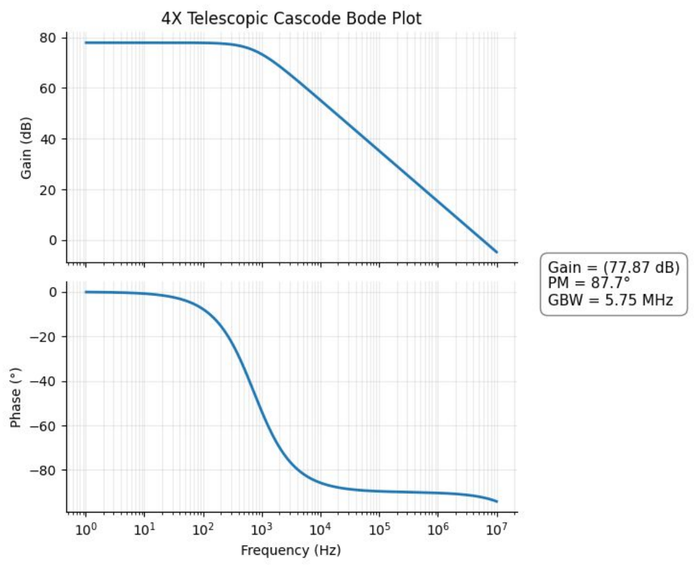
[picture p60: figure]

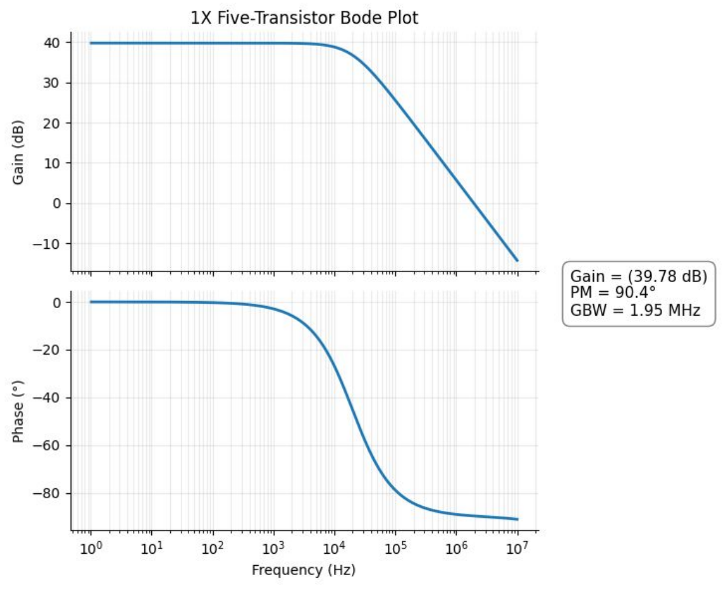
[picture p61: figure]

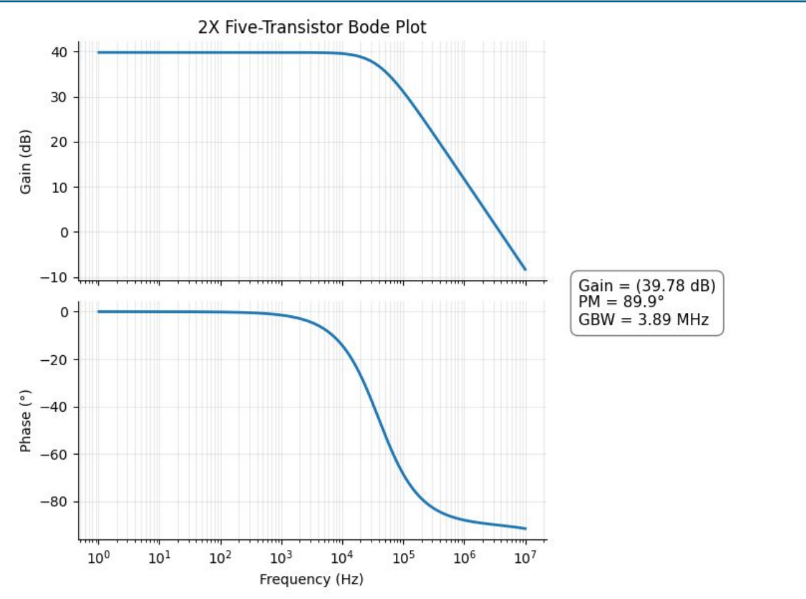
[picture p62: figure]

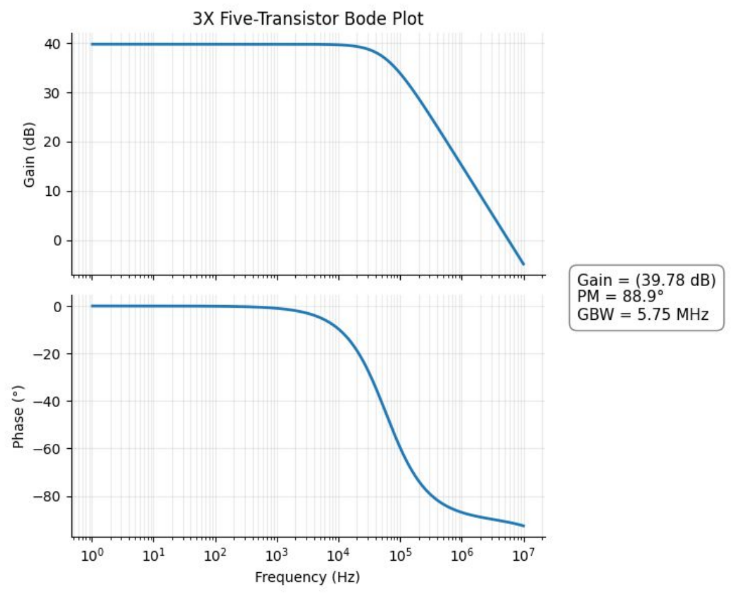
[picture p63: figure]

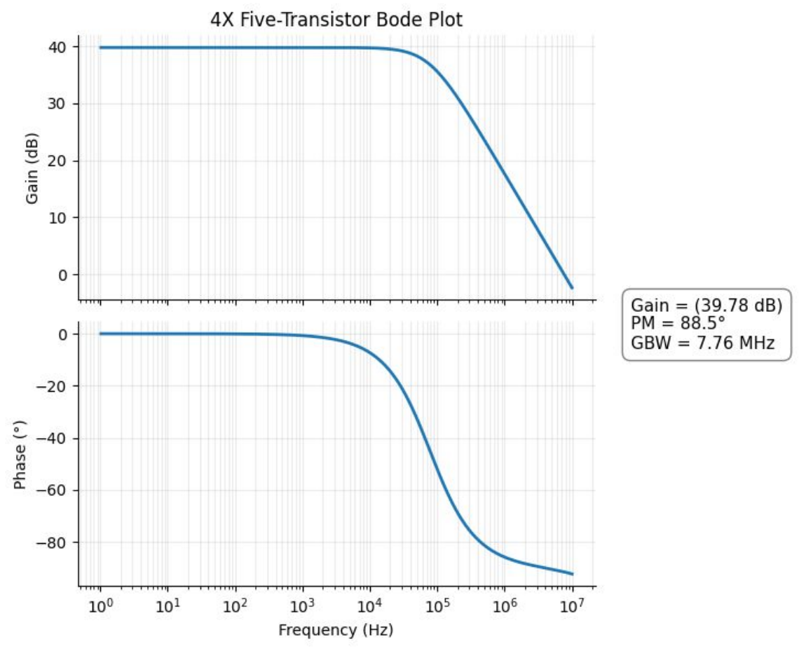
[picture p64: figure]

Four Topology MOSbius as an Inverting Amplifier

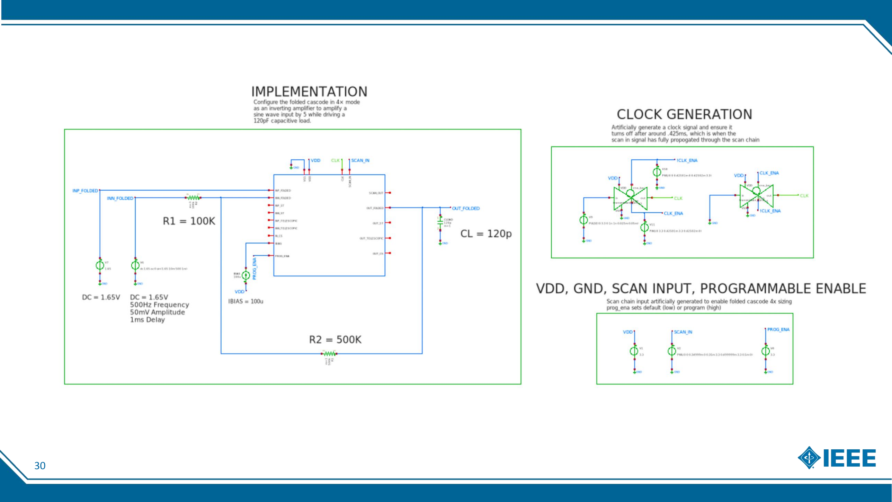
[picture p65: page 30]
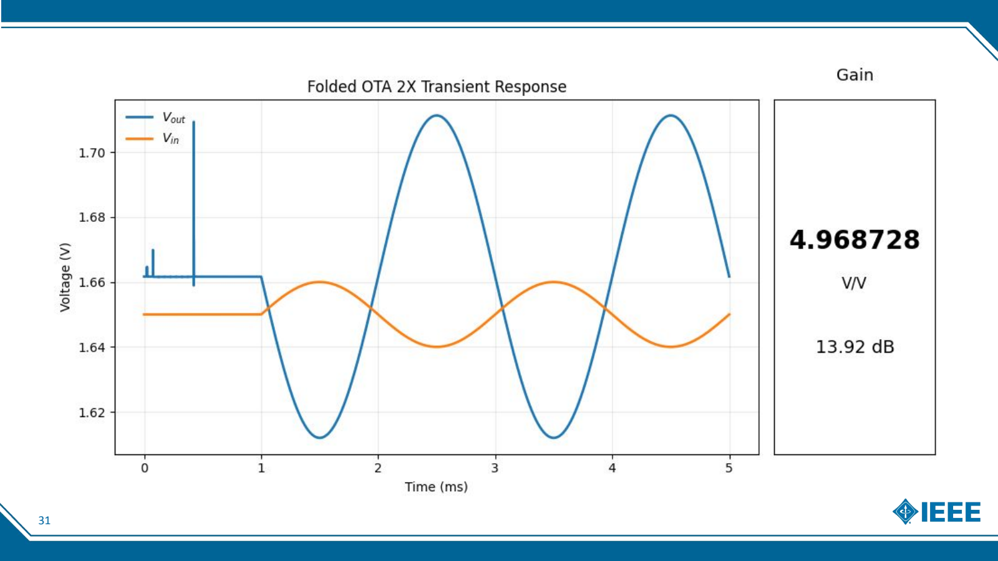
[picture p66: page 31]
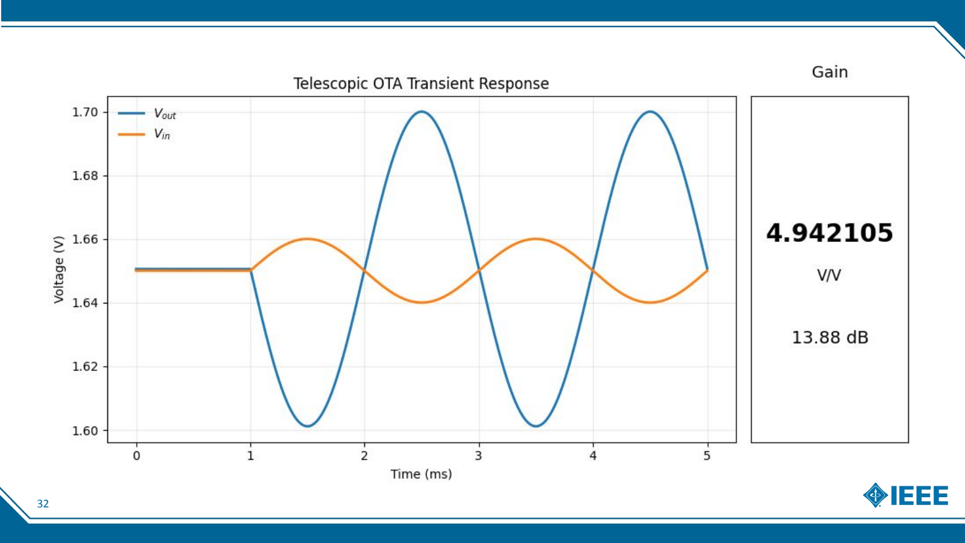
[picture p67: page 32]
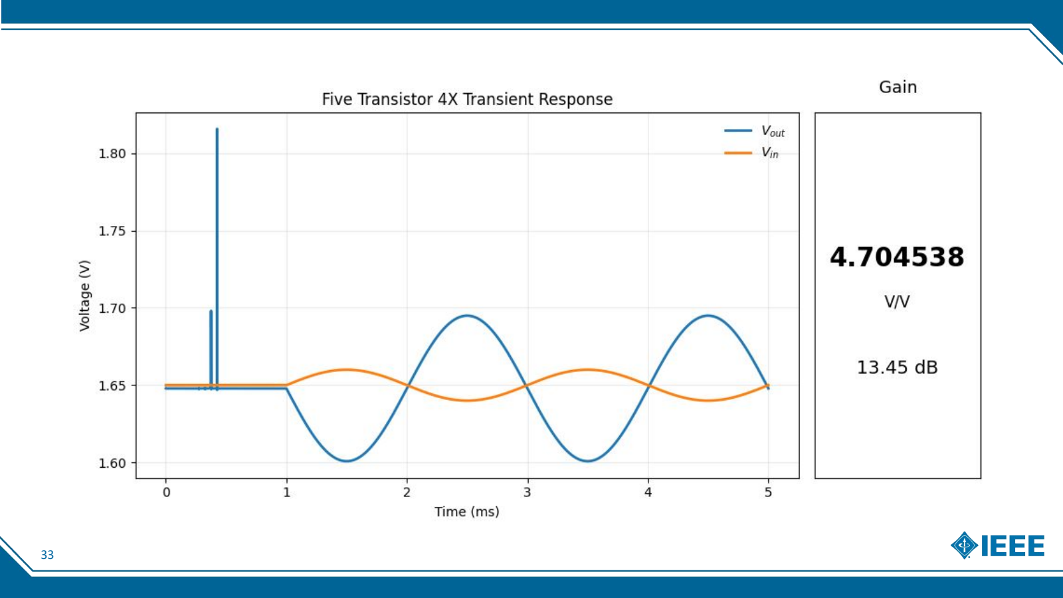
[picture p68: page 33]

Four Topology MOSbius as a Two-Stage Amplifier

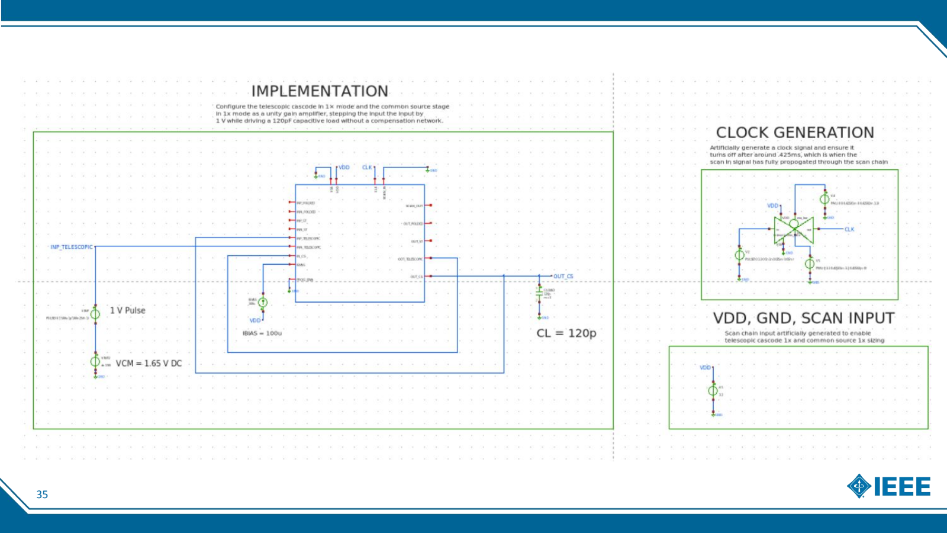
[picture p69: page 35]
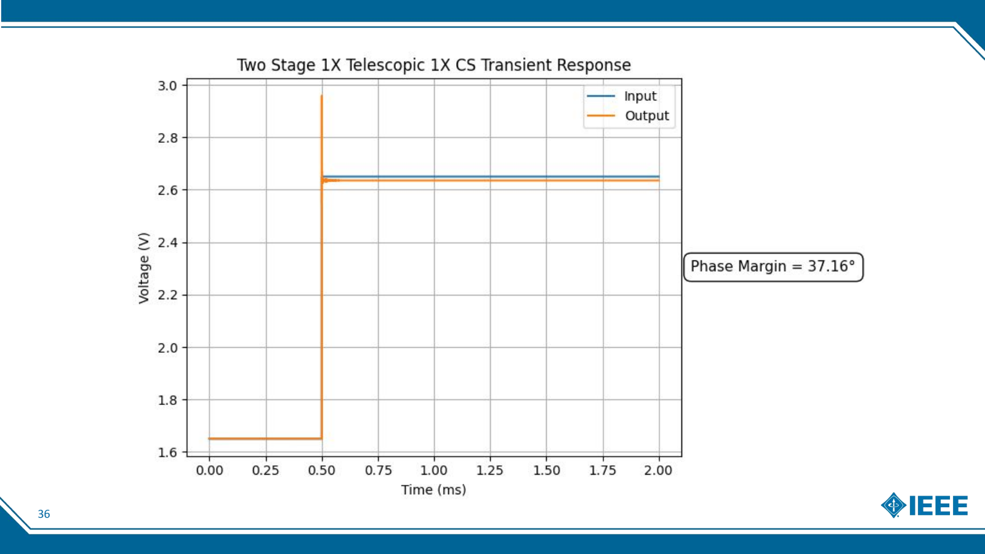
[picture p70: page 36]
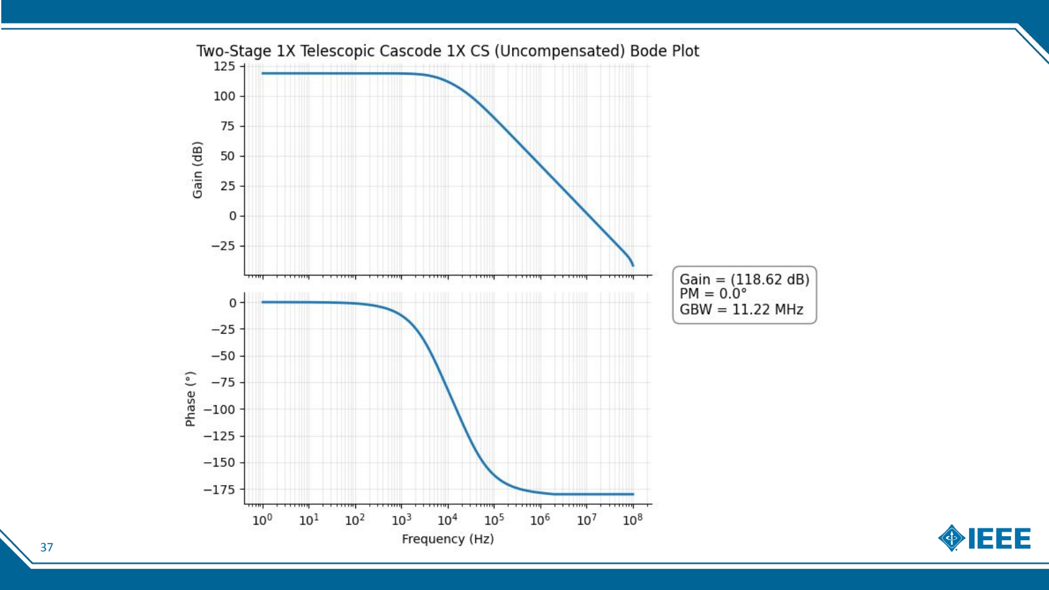
[picture p71: page 37]

Two-Stage Compensation

Users can also implement a Miller capacitor and compensation resistor to stabilize their amplifier configuration.

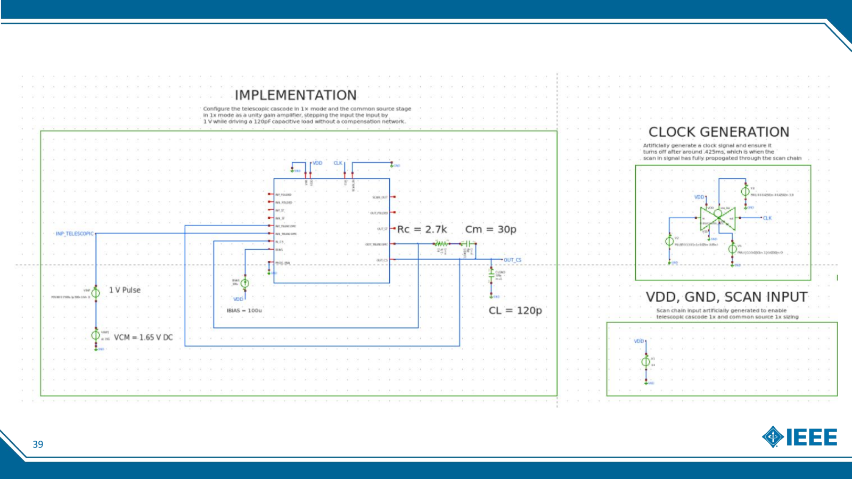
[picture p72: page 39]
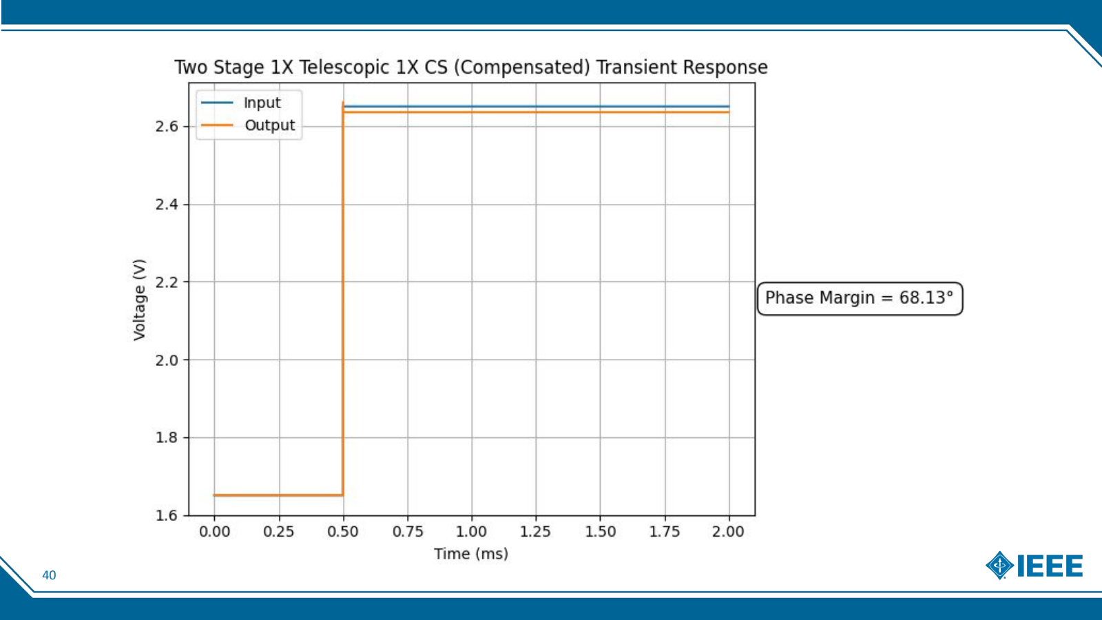
[picture p73: page 40]

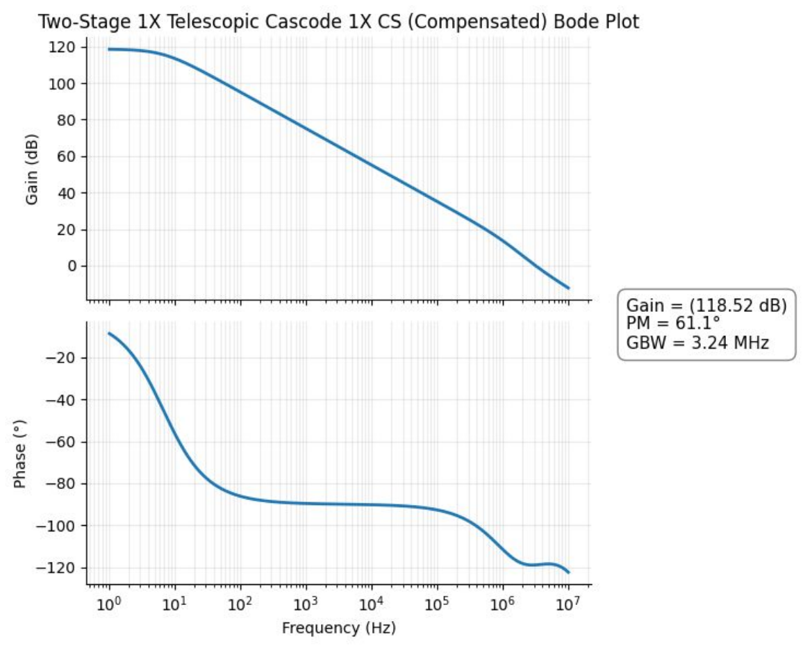
[picture p74: figure]

Full Verification Results:

Folded Cascode OTA:
https://docs.google.com/spreadsheets/d/1ste8NNTPVhHXfTPsn5K2P177Z7tUey5MOiy1HPbO30U/edit?usp=sharing (https://docs.google.com/spreadsheets/d/1ste8NNTPVhHXfTPsn5K2P177Z7tUey5MOiy1HPbO30U/edit?usp=sharing)

Telescopic Cascode OTA:
https://docs.google.com/spreadsheets/d/1UWE3XYKk2p_d3-MaK_v5p6VSCiXoplRrxV4e-1WU_l0/edit?usp=sharing (https://docs.google.com/spreadsheets/d/1UWE3XYKk2p_d3-MaK_v5p6VSCiXoplRrxV4e-1WU_l0/edit?usp=sharing)

5-Transistor OTA:
https://docs.google.com/spreadsheets/d/12NohRTnEUuWv6hk_VIJNx9IA-sGq2unuuVgBkl8fErU/edit?usp=sharing (https://docs.google.com/spreadsheets/d/12NohRTnEUuWv6hk_VIJNx9IA-sGq2unuuVgBkl8fErU/edit?usp=sharing)
