elijohnsonn/Four-Topology-MOSbius/(commit log)

2026-05-23 Add NMOS gm/Id characterization sweep data
    nfet_03v3, W=10u, Vds=1.65V, Vgs swept 0-3.3V. Five L values: 0.28u, 0.5u, 1u, 2u, 5u. Data files in libs/nmos_char/data/.
2026-05-24 Create inv.sch
    successfully sync
    [inv.sch]
2026-05-26 Test the workflow with inverter
    This commit is just a test for the fetch and push. Used inverter as a workflow example. Xschem, ngspice, and Klayout tutorial finished.
    [inv.sch, inv_tb.sch]
2026-05-27 5transistorOTA scratch
    5transistorOTA scratch.
    vcur is for Ibias
    [5tOTA.sch, untitled.sch]
2026-05-30 Created designs for an Inverter, NAND2 Gate, and D Flip Flop. Started a test bench creation for D Flip Flop.
    [D_ff1.sch, Dff1.sch, NAND2.sch, TB_D_ff1.sch, inv1.sch]
2026-05-30 folded schematic
2026-05-31 updating schematic, fixing .op
2026-06-03 updates on schematics
    [untitled-1.sch, untitled.sch]
2026-06-04 Moved to core_digital folder
    [Dff1.sch]
2026-06-06 5t_OTA schematic & symbol made
    5t_OTA schematic & symbol made, each pin was labeled too
    [5tOTA.sch]
2026-06-06 5t_OTA test bench made
    5t_OTA test bench made, symbol modified
    [5tOTA_tb.sch, untitled.sch]
2026-06-06 470pF load capacitor added.
    470pF load capacitor added. (15.33*15.33*2f*1000)
    [5tOTA_tb.sch]
2026-06-06 finish folded design, make symbol
    [untitled-1.sch, untitled.sch]
2026-06-06 first 5tOTA sizing design
    first sizing design.
    NMOS
    L=0.5u
    W=22.86u
    L=0.5u
    W=11.43u
    PMOS
    W double of NMOS
    [5tOTA.sch]
2026-06-07 simulation debug
    simulation debug
    [5tOTA.sch, 5tOTA_tb.sch]
2026-06-07 save
    save
    [5tOTA_tb.sch]
2026-06-07 ota symbol and connection issues fixed
    [5tOTA_tb.sch]
2026-06-07 OP simulation success
    OP simulation success.
    I bias = 100u,
    id = 50u in both branch
    [5tOTA.sch, 5tOTA_tb.sch]
2026-06-08 5t ota design sizing verified
    5t ota design sizing verified
    gm/id ~10, meets our required 10.
    DC unity simulation
    [5tOTA.sch, 5tOTA_tb2.sch]
2026-06-10 5tOTA dc, ac simulations
    5tOTA dc, ac simulations
    [5tOTA_tb2.sch, 5tOTA_tb_ac.sch, 5tOTA_tb_dc.sch, 5tOTA_tb_tran.sch]
2026-06-10 trans, open loop ac simulation done
    trans, open loop ac simulation done
    [5tOTA_tb_ac.sch, 5tOTA_tb_dc.sch, 5tOTA_tb_tran.sch]
2026-06-13 Fixed saturation issues, replacing ideal voltage sources
2026-06-13 made programmable fet, started TB
2026-06-17 cs stage design
2026-06-17 file structure fix
    move 5tOTA files from home directory to libs/core_amps/ota_5t
    [inv.sch, inv_tb.sch]
2026-06-21 schematic generation
2026-06-21 Added fingers and multipliers to programmable fets
2026-06-23 two stage amplifier testing
2026-06-24 two stage configuration
    [untitled.sch]
2026-06-24 some more two stage
2026-06-24 programmable 5t ota schematic and sym created
2026-06-24 programmable 5t ota schematic and symbol finished
2026-06-24 Created Scan chain symbol and schematic
2026-06-26 Finished symbol started TB
    [TB_scan_chain.sch]
2026-06-27 Scain Chain tested
    [TB_scan_chain.sch]
2026-06-27 resizing folded cascode
    [untitled.sch]
2026-06-28 making symbol
    [etj_folded_new_sym.sch, untitled.sch]
2026-06-28 Cleaned up programmable FET schematics
2026-06-28 updating schematics
    [etj_folded_new_sym.sch]
2026-06-28 ac and dc sims
    [untitled.sch]
2026-06-29 schematic tidying
2026-06-29 Schematic labeling
2026-06-30 annotated simulations and schematic
2026-06-30 updating programmable schematic
2026-06-30 Add schematic_review directory
2026-06-30 Rename schematic_review to schematic review
2026-07-02 Changed scan chain symbol and messed around with waveforms
2026-07-04 two stages
2026-07-05 fixing programmable cs
    [untitled.sch]
2026-07-05 fixing cs stage again, two stage
2026-07-05 cleaning up two stage tb
2026-07-07 Miller comp + current mirror resize, forgot to push this :(
2026-07-08 eliminating one bias current, fix cs
2026-07-08 cleaning up
    [untitled.sch]
2026-07-09 telescopic DUT tb's
    [untitled-5.sch]
2026-07-14 clean up and sims
    [untitled-5.sch]
2026-07-14 editing schematic, generating txt
2026-07-14 need new branch, integrator and unity step added here
    [untitled-5.sch]
2026-07-15 debugging 5T bias shift
    [untitled.sch]
2026-07-15 clean up
    [untitled.sch]
2026-07-16 setting up default
    [untitled-1.sch, untitled.sch]
2026-07-17 added default transistors and pull down resistors
2026-07-18 Installed Progamming Enable
    [untitled.sch]
2026-07-21 making new testbenches
    [untitled-1.sch, untitled-2.sch]
2026-07-22 clean up files
    [untitled-1.sch, untitled-2.sch, untitled.sch]
2026-07-23 making large signal tb
    [untitled.sch]
2026-07-26 Finished both prog for cs stage
2026-07-28 M1 and M2 switched
2026-08-01 Scan chain DRC and LVS clean after flattening netlist
2026-08-02 Routed IBIAS to CS stage
2026-08-10 Starting pin making
2026-08-10 Starting power grid
2026-08-11 Everything but folded routed and powered
2026-08-17 made a switch to clean start up glitch
2026-08-20 Moved GND pin
2026-08-23 3x inverting simulation with start up circuitry
2026-08-23 def file wired
2026-08-25 voltage fix, cap removed, re plot
2026-09-01 make device list
2026-09-02 make pin list
2026-09-04 Added slots, and fixed small gaps
